bindebende/HILTester/(list of files, cad)

Other CAD files:
ExtensionBoards/PinBed_FOR_A3.stp
ExtensionBoards/PinBed_FOR_A3.skp
