bindebende/HILTester/(threads)

Thread 2 (2017-06-03):

Supply ON/OFF switch

bindebende, 2017-06-03:
Turn on off supply with p-channel mosFET

bindebende, 2017-06-04:
implemented with changing the LDO to TL1963AKTTR.which have internal shdn pin which is pulled up to tstr_3V3

Closed 2017-06-04.

Thread 11 (2017-06-05):

find a suitable power toggle switch

bindebende, 2017-06-05:
switch with 4.7 mm pin spacing
http://hu.farnell.com/multicomp/1ms3t1b5m1qe/switch-spdt-on-off-on-5a-28vdc/dp/9473386

bindebende, 2017-10-11:
Done

Closed 2017-10-11.

Thread 29 (2017-07-23):

Create a break out board for the TIVA c EK with the A2.0 pinout

bindebende, 2017-07-23:
- [ ] Add pull up resistors
- [ ] Add two GEN_IN input for ADC inputs. Connect together with a jumper
- [ ] Add BNC connectors

bindebende, 2017-10-16:
not implemented

Closed 2017-10-16.

Thread 31 (2017-09-22):

add Grouping to pinbed

bindebende, 2017-09-22:
Add pin headers where all the signals are connected from the pins (pogo) and the other side of the pins are connected to the header to the HIL. It could be jumper bypassable. Reason: put a PCB on top of it and change the pogopins which connector they are going for different group of tests.

Thread 34 (2017-10-02):

Add master slave modules

bindebende, 2017-10-02:
Jumper selectable. Modules are connected with communicatin lines RS485,diff I2c

Handshake each module has a ID and when the MCU ask for handshake the slaves will continue it when the delay(ID*millisec) expires. then the master will controll all the message control flow

bindebende, 2017-10-23:
It will be coded in the eeprom

Closed 2017-10-23.

Thread 35 (2017-10-02):

Make the board bottom layer the front panel of case

bindebende, 2017-10-02:
- the multiplexers have to put on the top side
- connectors have to be put on the bottom layer
- put leds which are emmiting on their bottom and add a cut out to the pcb

bindebende, 2017-10-16:
Not implemented

Closed 2017-10-16.

Thread 43 (2017-10-10):

Fix the tarces next to the LDO3's shunt resistor from the MCU

bindebende, 2017-10-10:

bindebende, 2017-10-11:
Done

Closed 2017-10-11.

Thread 45 (2017-10-10):

programer board

bindebende, 2017-10-10:
Turn on and off power rail for all the DUTs programming one at the time (high side on/off p-ch mosfet)

Thread 47 (2017-10-11):

Add board temperature measurement

bindebende, 2017-10-11:
put close to the LDOs
NTC
http://hu.farnell.com/avx/nb20m00333kba/thermistor-ntc-33k-1206/dp/1672317

bindebende, 2017-10-23:
Done

Closed 2017-10-23.

Thread 48 (2017-10-11):

Input divider on analog pins

bindebende, 2017-10-11:
Scope like 1:10 and 1:1 selectable with p-channel MOSFET, or with Relay
some kind of IO expander will be using because there's no 40 free pins available and the switching doesn't have to be fast (max 1Hz per ch)
Dividing options:
* 1:1
* 1:2
* 10:1

IO Expander (40 I/O I2c, Totem pole output, 100kOhm pull up) :
http://hu.farnell.com/nxp/pca9505dgg/ic-i-o-port-i2c-40bit-56tssop/dp/2212087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

Example mosfet (-30Vds )
http://hu.farnell.com/nxp/nx3008pbks/mosfet-pp-ch-30v-200ma-sot363/dp/2069548

bindebende, 2018-02-01:
Or digital too

Thread 54 (2017-10-14):

control output supply voltage of the LDOs

bindebende, 2017-10-14:
* measure input voltage with 1/6 voltage divider
* digital resistor in the feedback signal of the LDO's (remove the fixed resistors)
Cons: +-20% accuracy
http://hu.farnell.com/maxim-integrated-products/ds3501u/digital-pot-10k-single-usop-10/dp/2515880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
* ADC
http://hu.farnell.com/maxim-integrated-products/max11647eua/adc-2-ch-sar-10bit-94-4ksps-umax/dp/2513428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

bindebende, 2017-10-25:
Done

Closed 2017-10-25.

Thread 56 (2017-10-16):

Create order

bindebende, 2017-10-16:
run bom.ulp
Values -> .csv

- [ ] generate BOM
- [ ] search for the components (preferable on farnell)
- [ ] put them in the BOM
- [ ] order components
- [ ] print the layout and try the components if are they fits on
- [ ] order PCB

bindebende, 2017-10-19:
Done

Closed 2017-10-19.

Thread 57 (2017-10-16):

Generate outputs

bindebende, 2017-10-16:
Gerbers:
* Component
    * TOP
    * PADS
    * VIAS
* Solder
    * BOTTOM
    * PADS
    * VIAS
* Component silk
    * Dimension
    * TPLACE
    * TNAMES
* solder silk
    * Dimension
    * BPLACE
    * BNAMES
* solder stop
    * Tstop
* component stop
    * Bstop
* component keepout(cko)
    * TKeepout
* solder keepout(sko)
    * BKeepout
* Drill(ncd, Excellon)
    * Drills
    * Holes

PDF:
* schematic (all the pages)
* layout (without the ground plane)
* assembly drawing

bindebende, 2017-10-16:
Done

Closed 2017-10-16.

Thread 59 (2017-10-16):

Add test pins

bindebende, 2017-10-16:
http://hu.farnell.com/w/c/test-measurement/test-connectors-ic-clips/pcb-test-points/prl/results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

To:
* Multiplexer Control signals
* LDOs Control signal
* GND for scope grounding

bindebende, 2017-10-16:
Done. Add a pin header wher all the pin can be connected

Closed 2017-10-16.

Thread 61 (2017-10-17):

Relay board

bindebende, 2017-10-17:
For signals short to GND, Supply, each other (e.g.: SDA <-> SCL)
Check if a Darlington transistor array needed to drive the relays

Thread 67 (2017-10-18):

Add configuration memmory

bindebende, 2017-10-18:
* PCB specific:
    * HW revision
    * enabled peripherals like (CAN,LIN, SPI)
    * type of the peripherals (Display, SSD1306, 32x64)

* master/slave mode
* Hard error log

bindebende, 2017-10-23:
Done

Closed 2017-10-23.

Thread 72 (2017-10-19):

Add labels to the external (DUT) connector

bindebende, 2017-10-19:
The label place shall be between the connectors and the resistors. The PCB shall be expanded vertically

bindebende, 2017-10-24:
Done

Closed 2017-10-24.

Thread 74 (2017-10-19):

U9 supply is connected to VCC not TSTR_3v3

bindebende, 2017-10-19:
Fixed in schematic

Thread 76 (2017-10-20):

Add reverse protection on programming signals (JTAG, SWD, ICSP)

bindebende, 2017-10-20:
Schottky. Forward voltage might be a concern

Thread 77 (2017-10-20):

Supply's reverse input voltage protection

bindebende, 2017-10-20:
* P-chanel mosFET:
http://hu.farnell.com/on-semiconductor/atp101-tl-h/mosfet-p-ch-30v-25a-atpak/dp/2774815

bindebende, 2017-10-25:
Done

Closed 2017-10-25.

Thread 80 (2017-10-22):

LDO for TSTR_3V3 no input connected to any pin

bindebende, 2017-10-22:
Fixed in the schematic

Thread 81 (2017-10-22):

Isolate DUT inputs

bindebende, 2017-10-22:
For digital signals
http://hu.farnell.com/silicon-labs/si8660ba-b-is1/digital-isolator-8ns-nsoic-16/dp/2423337

bindebende, 2018-02-02:
Not implemented since the current isolation is:
* Current (with resistor)
* Voltage ( with zener diodes)

Closed 2018-02-02.

Thread 85 (2017-10-25):

find a buyable oscillator for the mcu

bindebende, 2017-10-25:
It shall match in the package too

http://hu.farnell.com/qantek-technology-corporation/qc3ca25-0000f18b23m/crystal-25mhz-18pf-3-2mm-x-2-5mm/dp/2508942

bindebende, 2017-10-25:
Done

Closed 2017-10-25.

Thread 102 (2018-02-02):

Flash silta to the discovery board

bindebende, 2018-02-02:
* DFU:

* OpenOCD:
    *  (desolder SB10 jumper)
    * Connect to the stm32f4-discovery board using the mini USB cable AND micro USB cable
    * Connect using openOCD and the included configuration file. $ openocd -f stm32f4xx-openOCD.cfg
    * On a separate terminal window, run arm-none-eabi-gdb $ arm-none-eabi-gdb
    * Connect to openOCD (gdb) target extended-remote localhost:3333
    * Load program the stm32f4xx (gdb) file build/silta.elf (gdb) load
    * To run you program: (gdb) continue

Closed 2018-02-03.
