bindebende/HILTester/HIL/Output/PDF/HIL_SCH.pdf

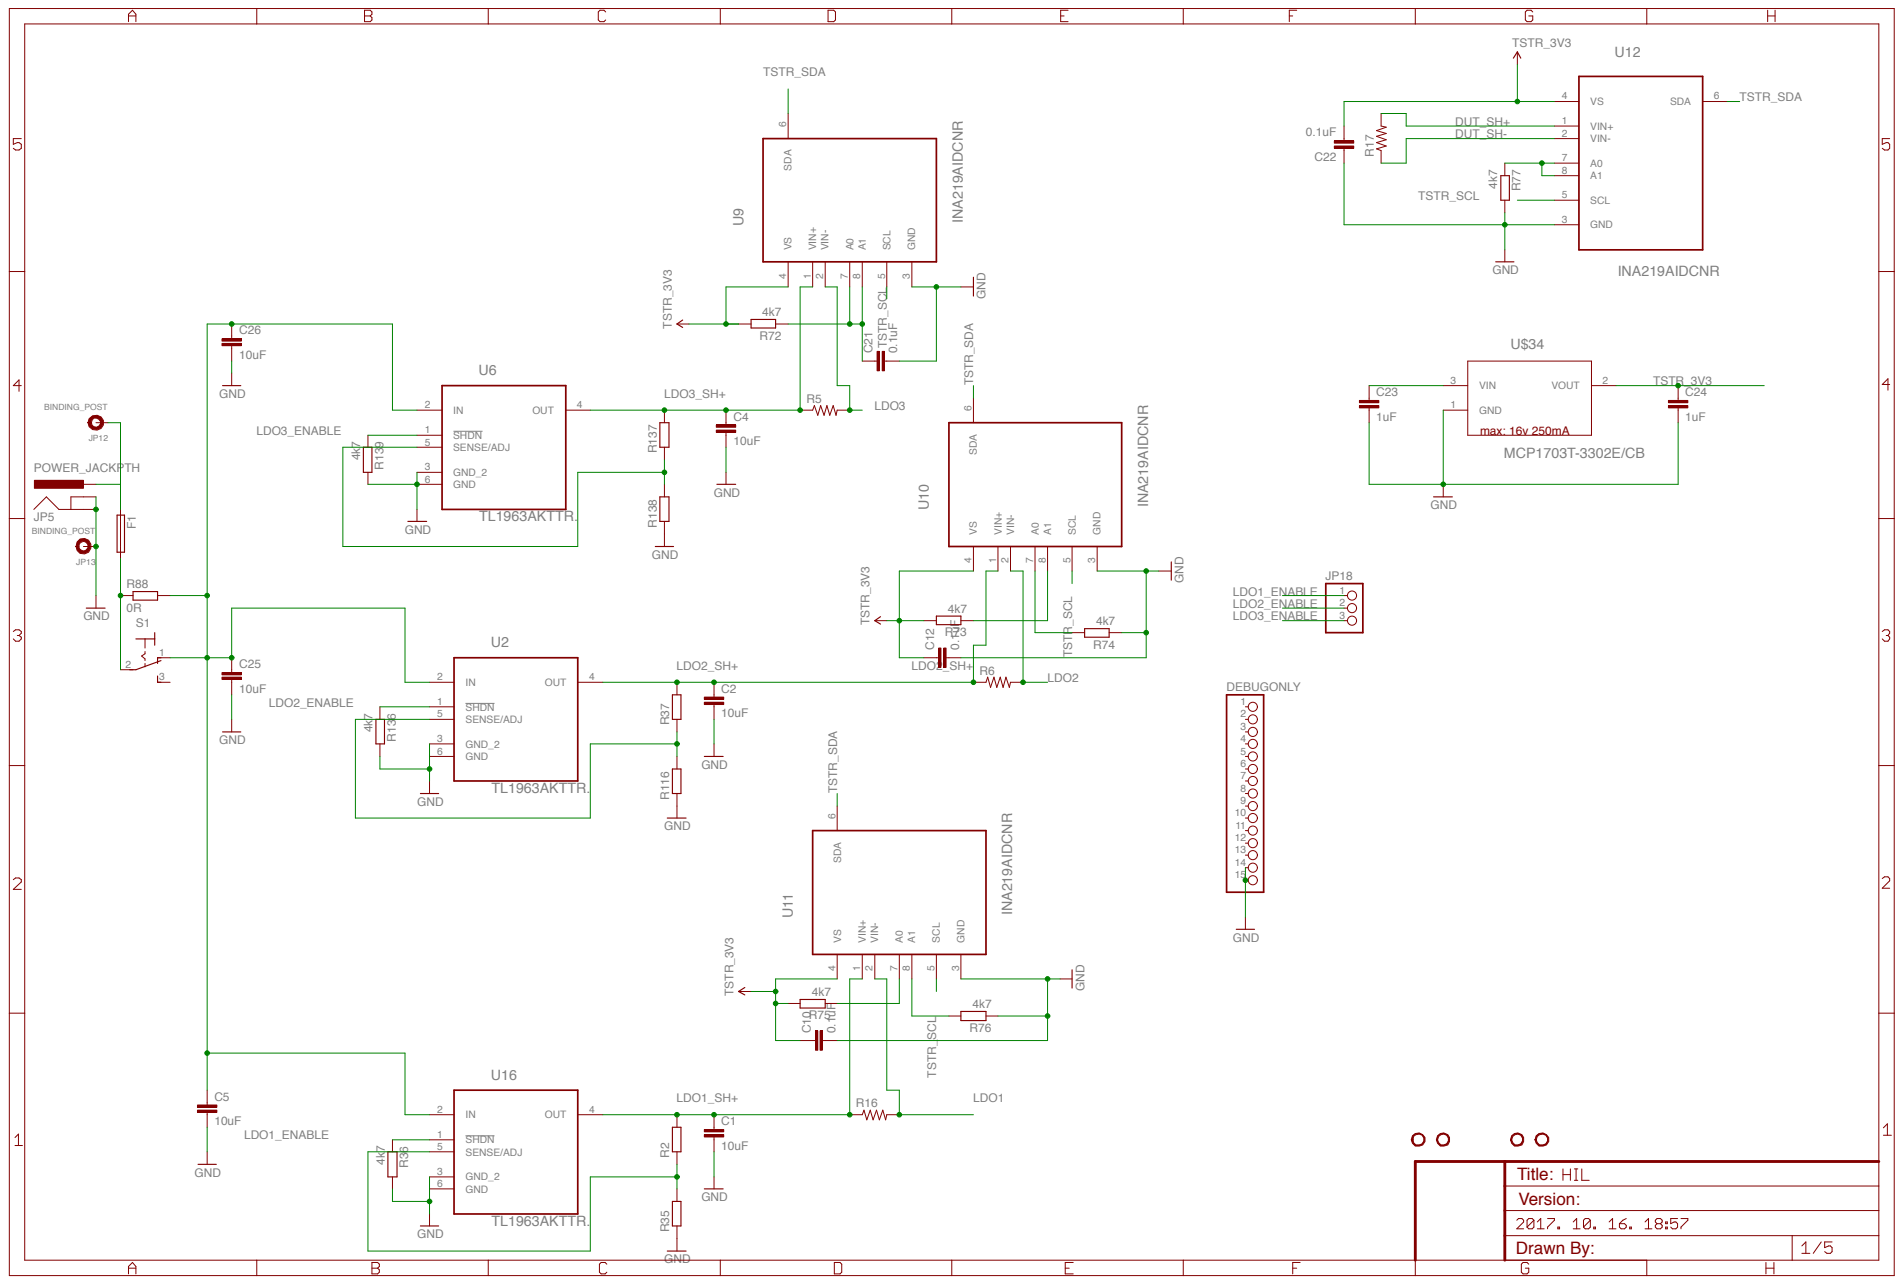
[picture p1: page 1]

TSTR_3V3

VIN+ 1

GND_2 3

Title:

# TSTR_3V3 DUT_CS_RecieveAllMSG4.7k GND

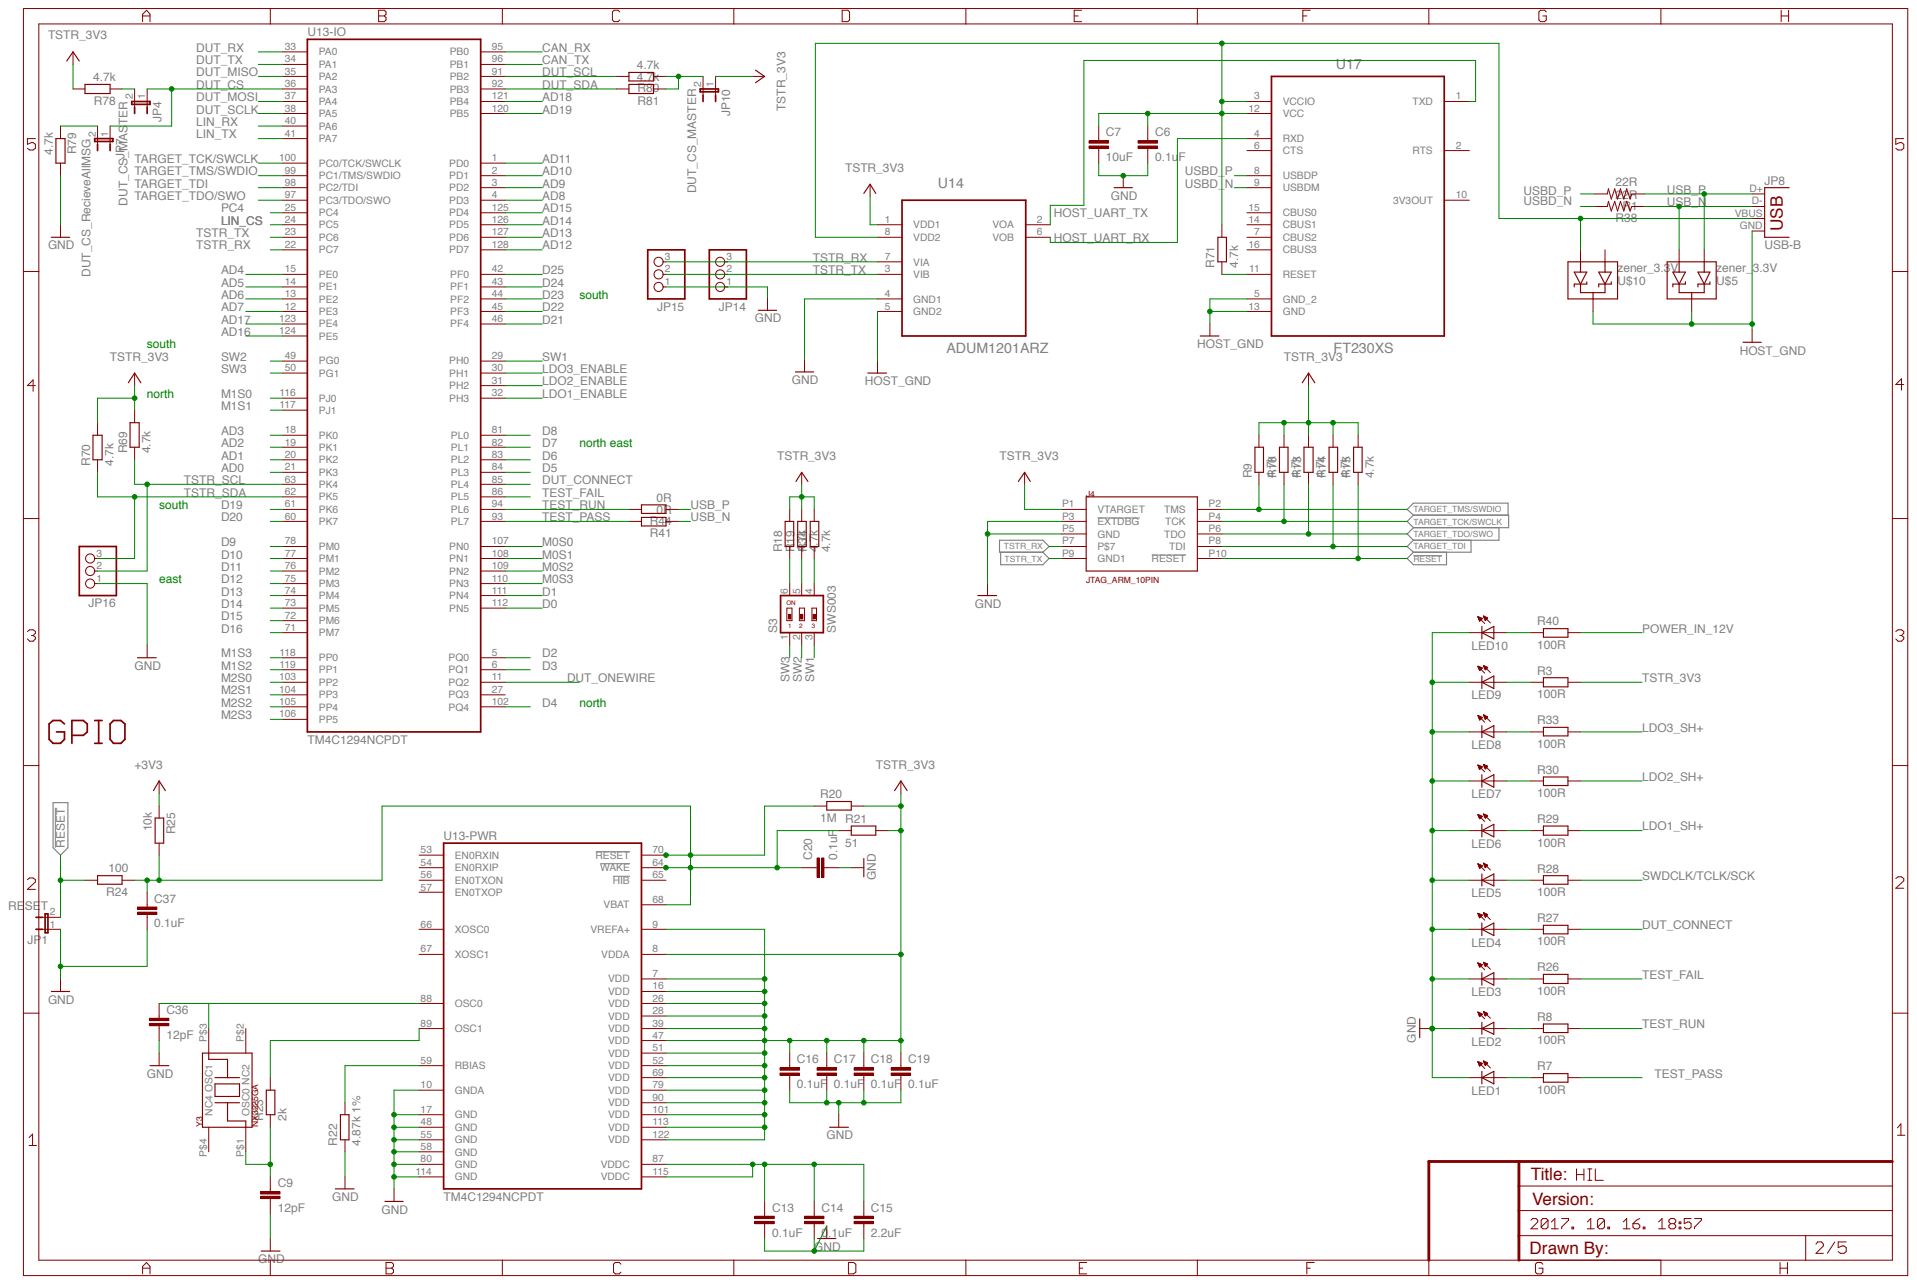
[picture p2: page 2]

# GND ⁴k7

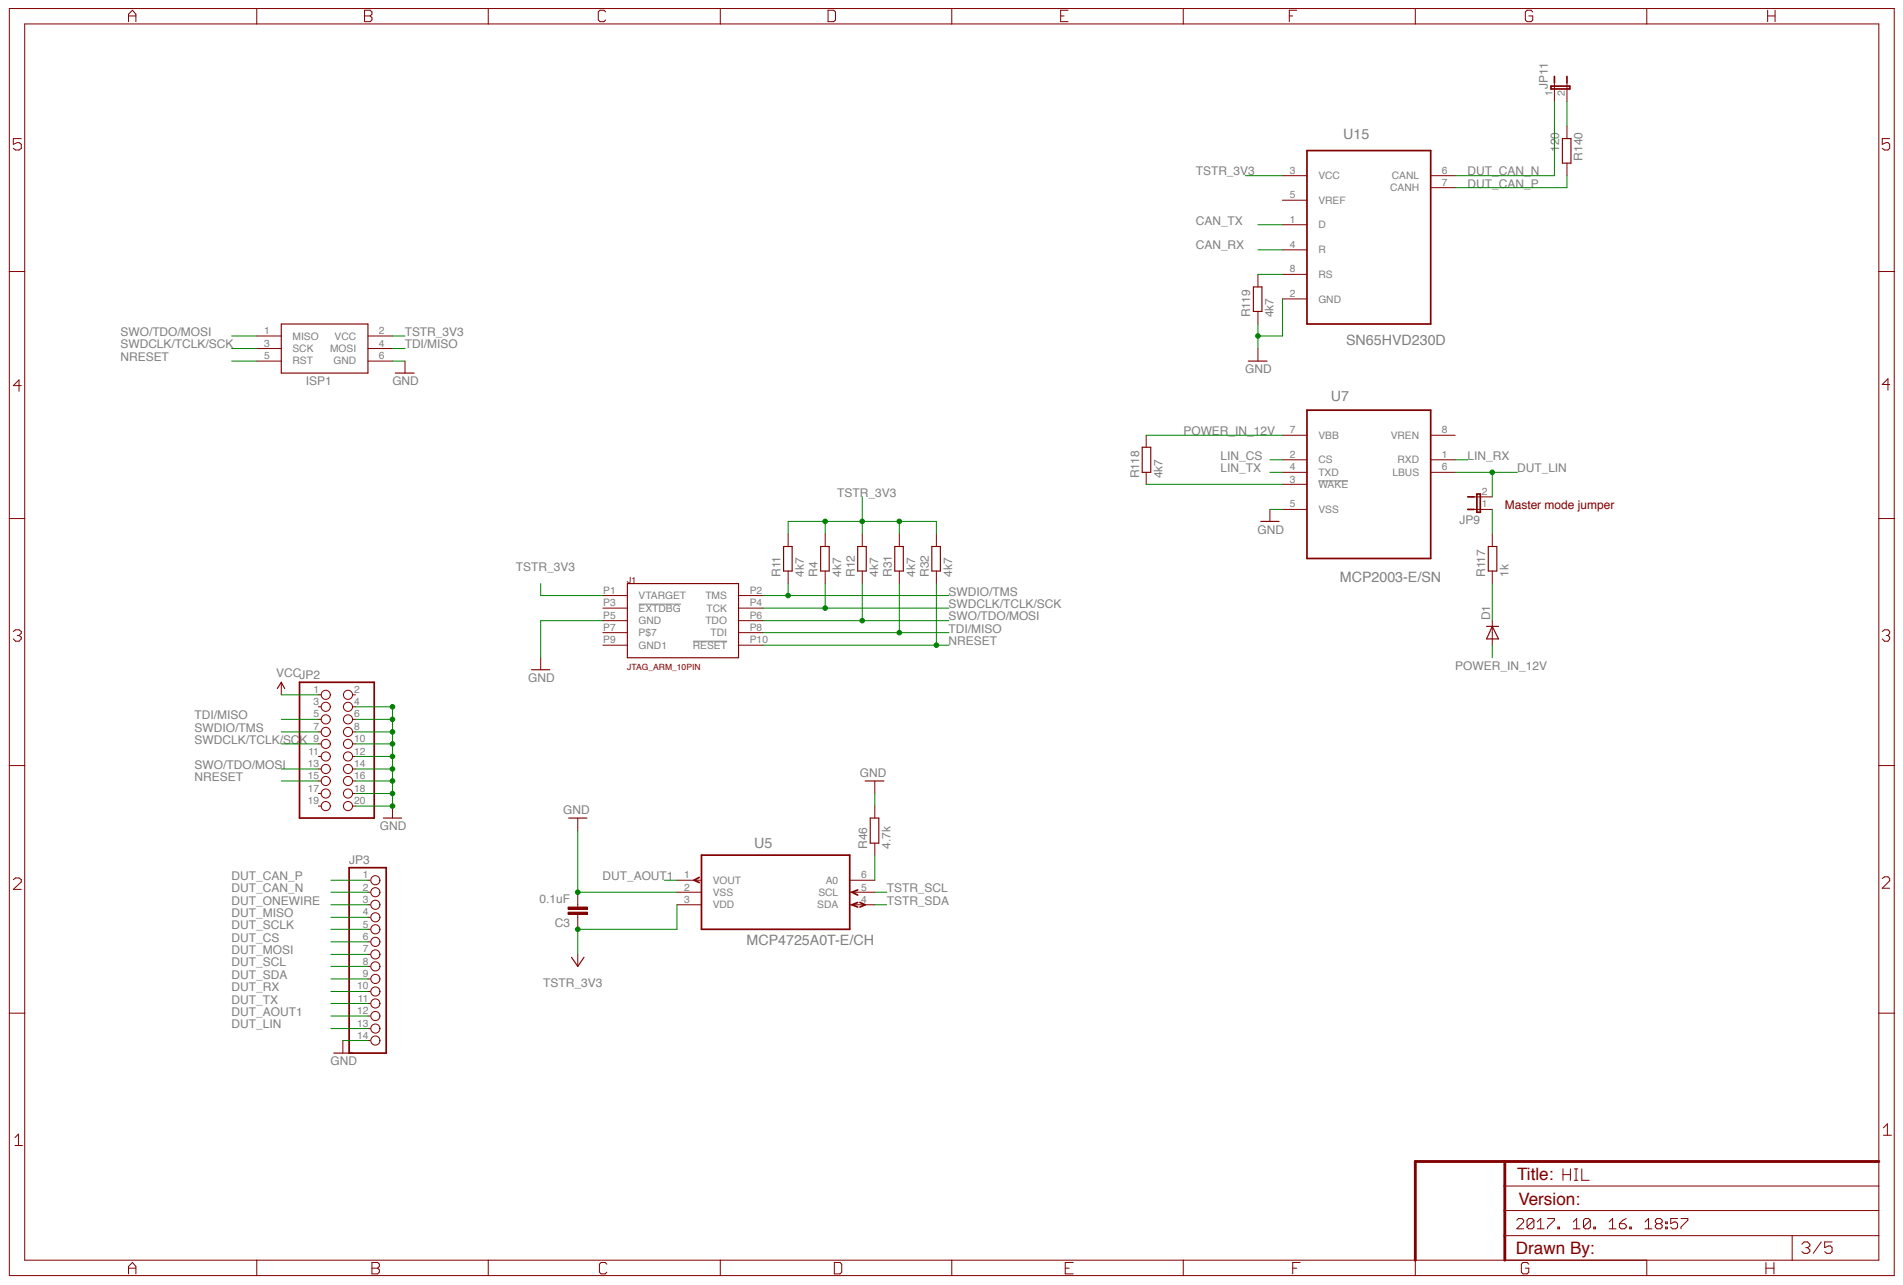
[picture p3: page 3]

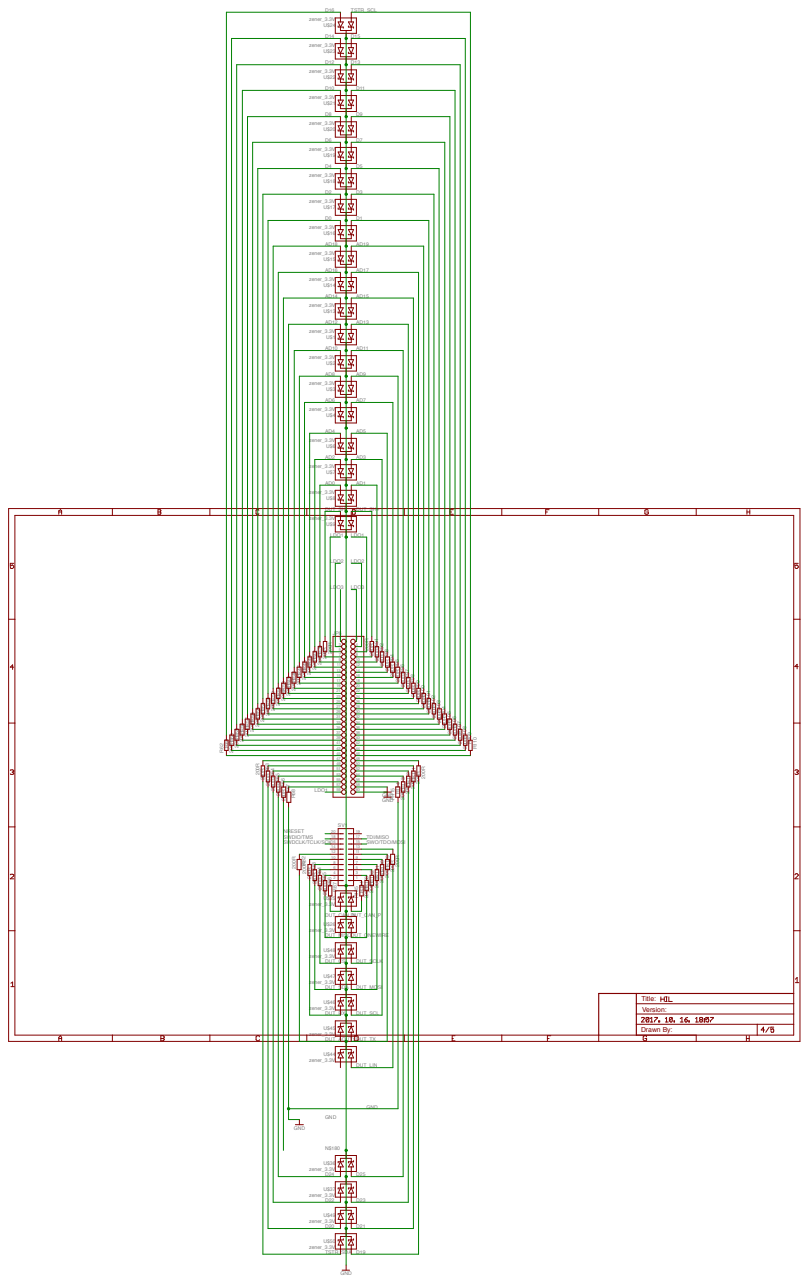
[picture p4: page 4]

zener_3.3V U$23

zener_3.3V U$22

zener_3.3V U$21

zener_3.3V U$20

zener_3.3V U$19

zener_3.3V U$18

zener_3.3V U$17

zener_3.3V U$16

zener_3.3V U$15

zener_3.3V U$14

zener_3.3V U$13

zener_3.3V U$2

zener_3.3V U$3

zener_3.3V U$6

zener_3.3V U$7

DUT_CAN_NDUT_CAN_P U$26 DUT_MISODUT_ONEWIRE

Drawn By:

DUT_AOUT1 | DUT_TX DUT_LIN

U$37 zener_3.3V D22 | | D23

U$49 zener_3.3V D20 | | D21

U$50 zener_3.3V

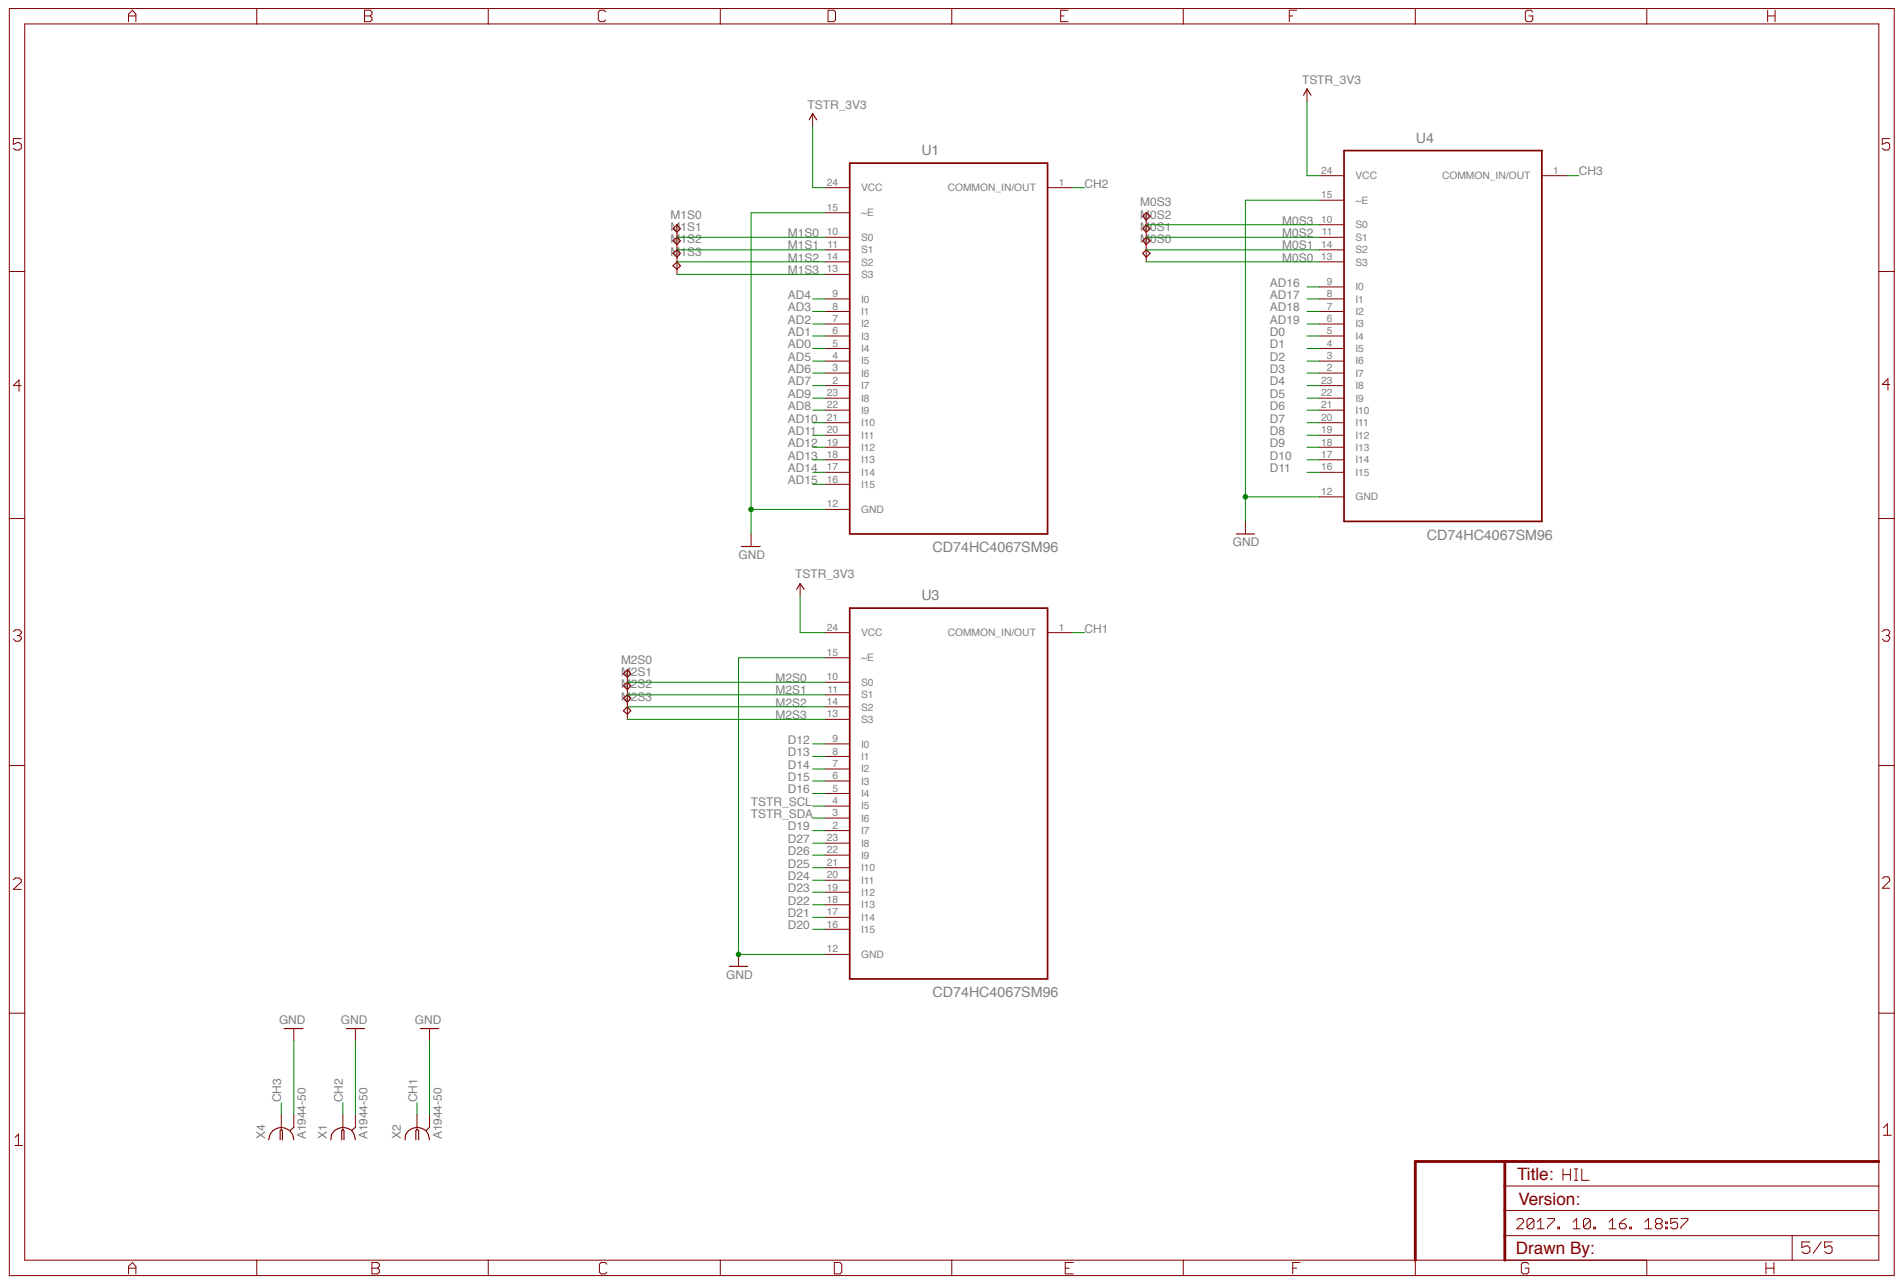
[picture p5: page 5]
