bindebende/HILTester/HIL/Output/PDF/HIL_ASM_TOP.pdf

*

1

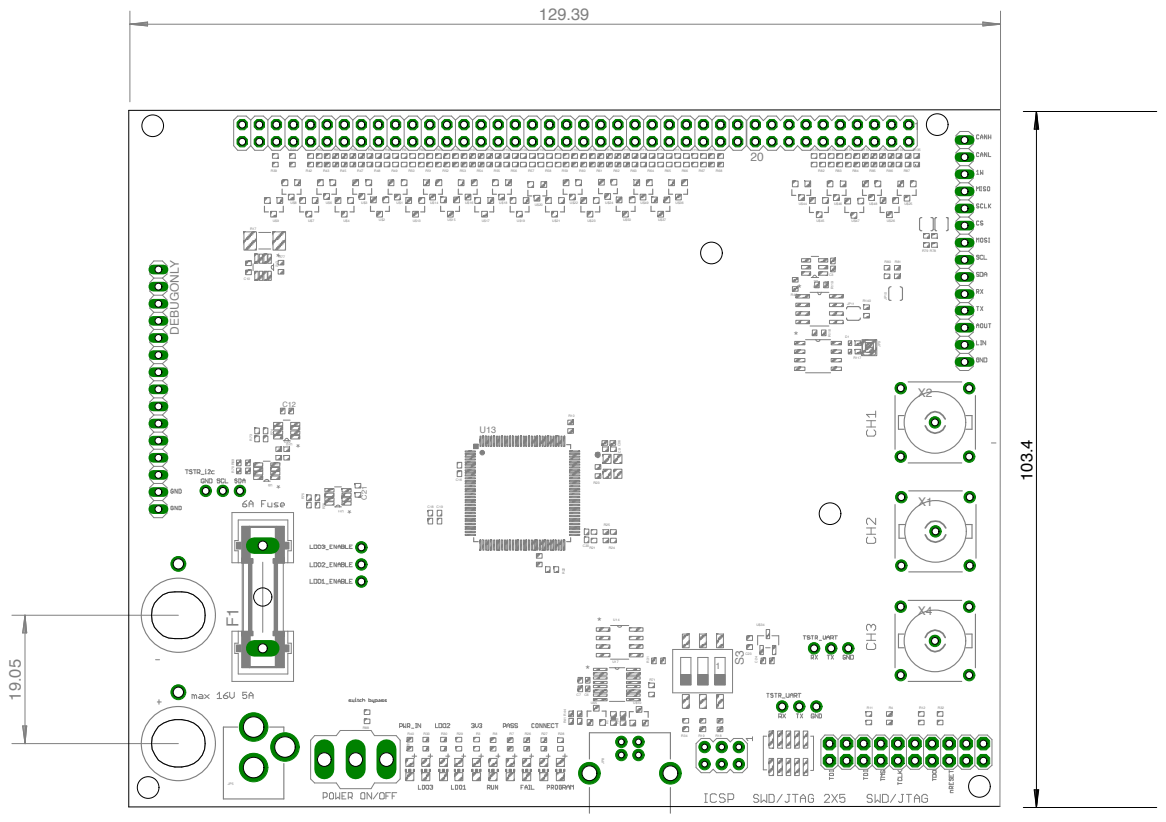
[picture p6: page 1]
