bindebende/HILTester/HIL/Output/PDF/HIL_LAY_BOTTOM.pdf

* | * M2S3 *

129.39

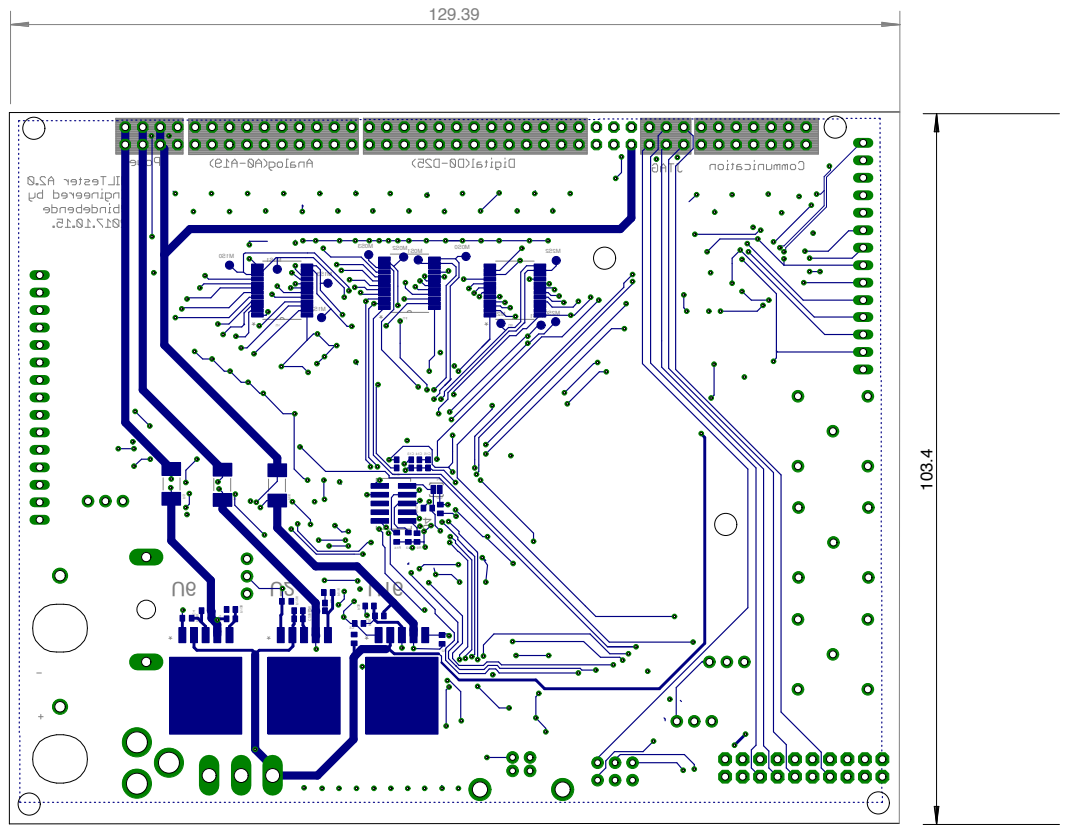
[picture p7: page 1]
