bindebende/HILTester/HIL/Output/PDF/HIL_LAY_TOP.pdf

*

1

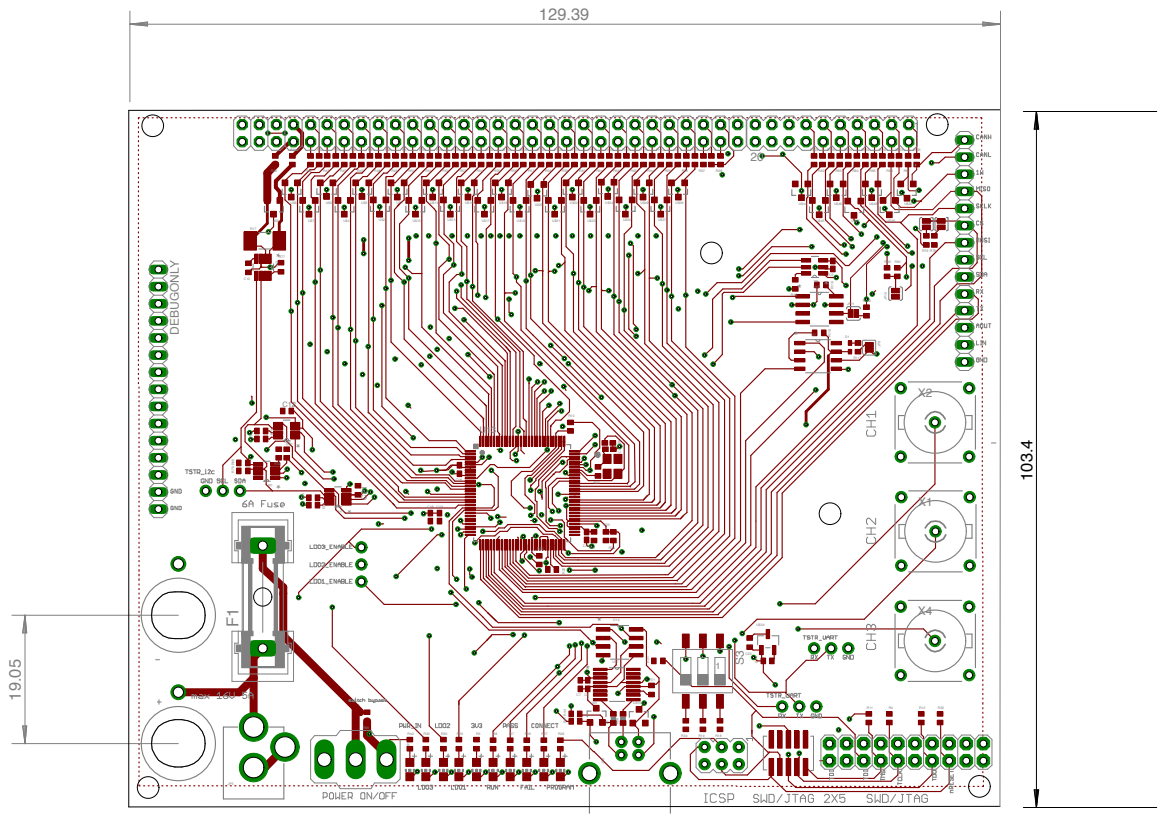
[picture p8: page 1]
