bindebende/HILTester/HIL/HIL.brd

## EAGLE design HIL/HIL.brd (2018-02-04)

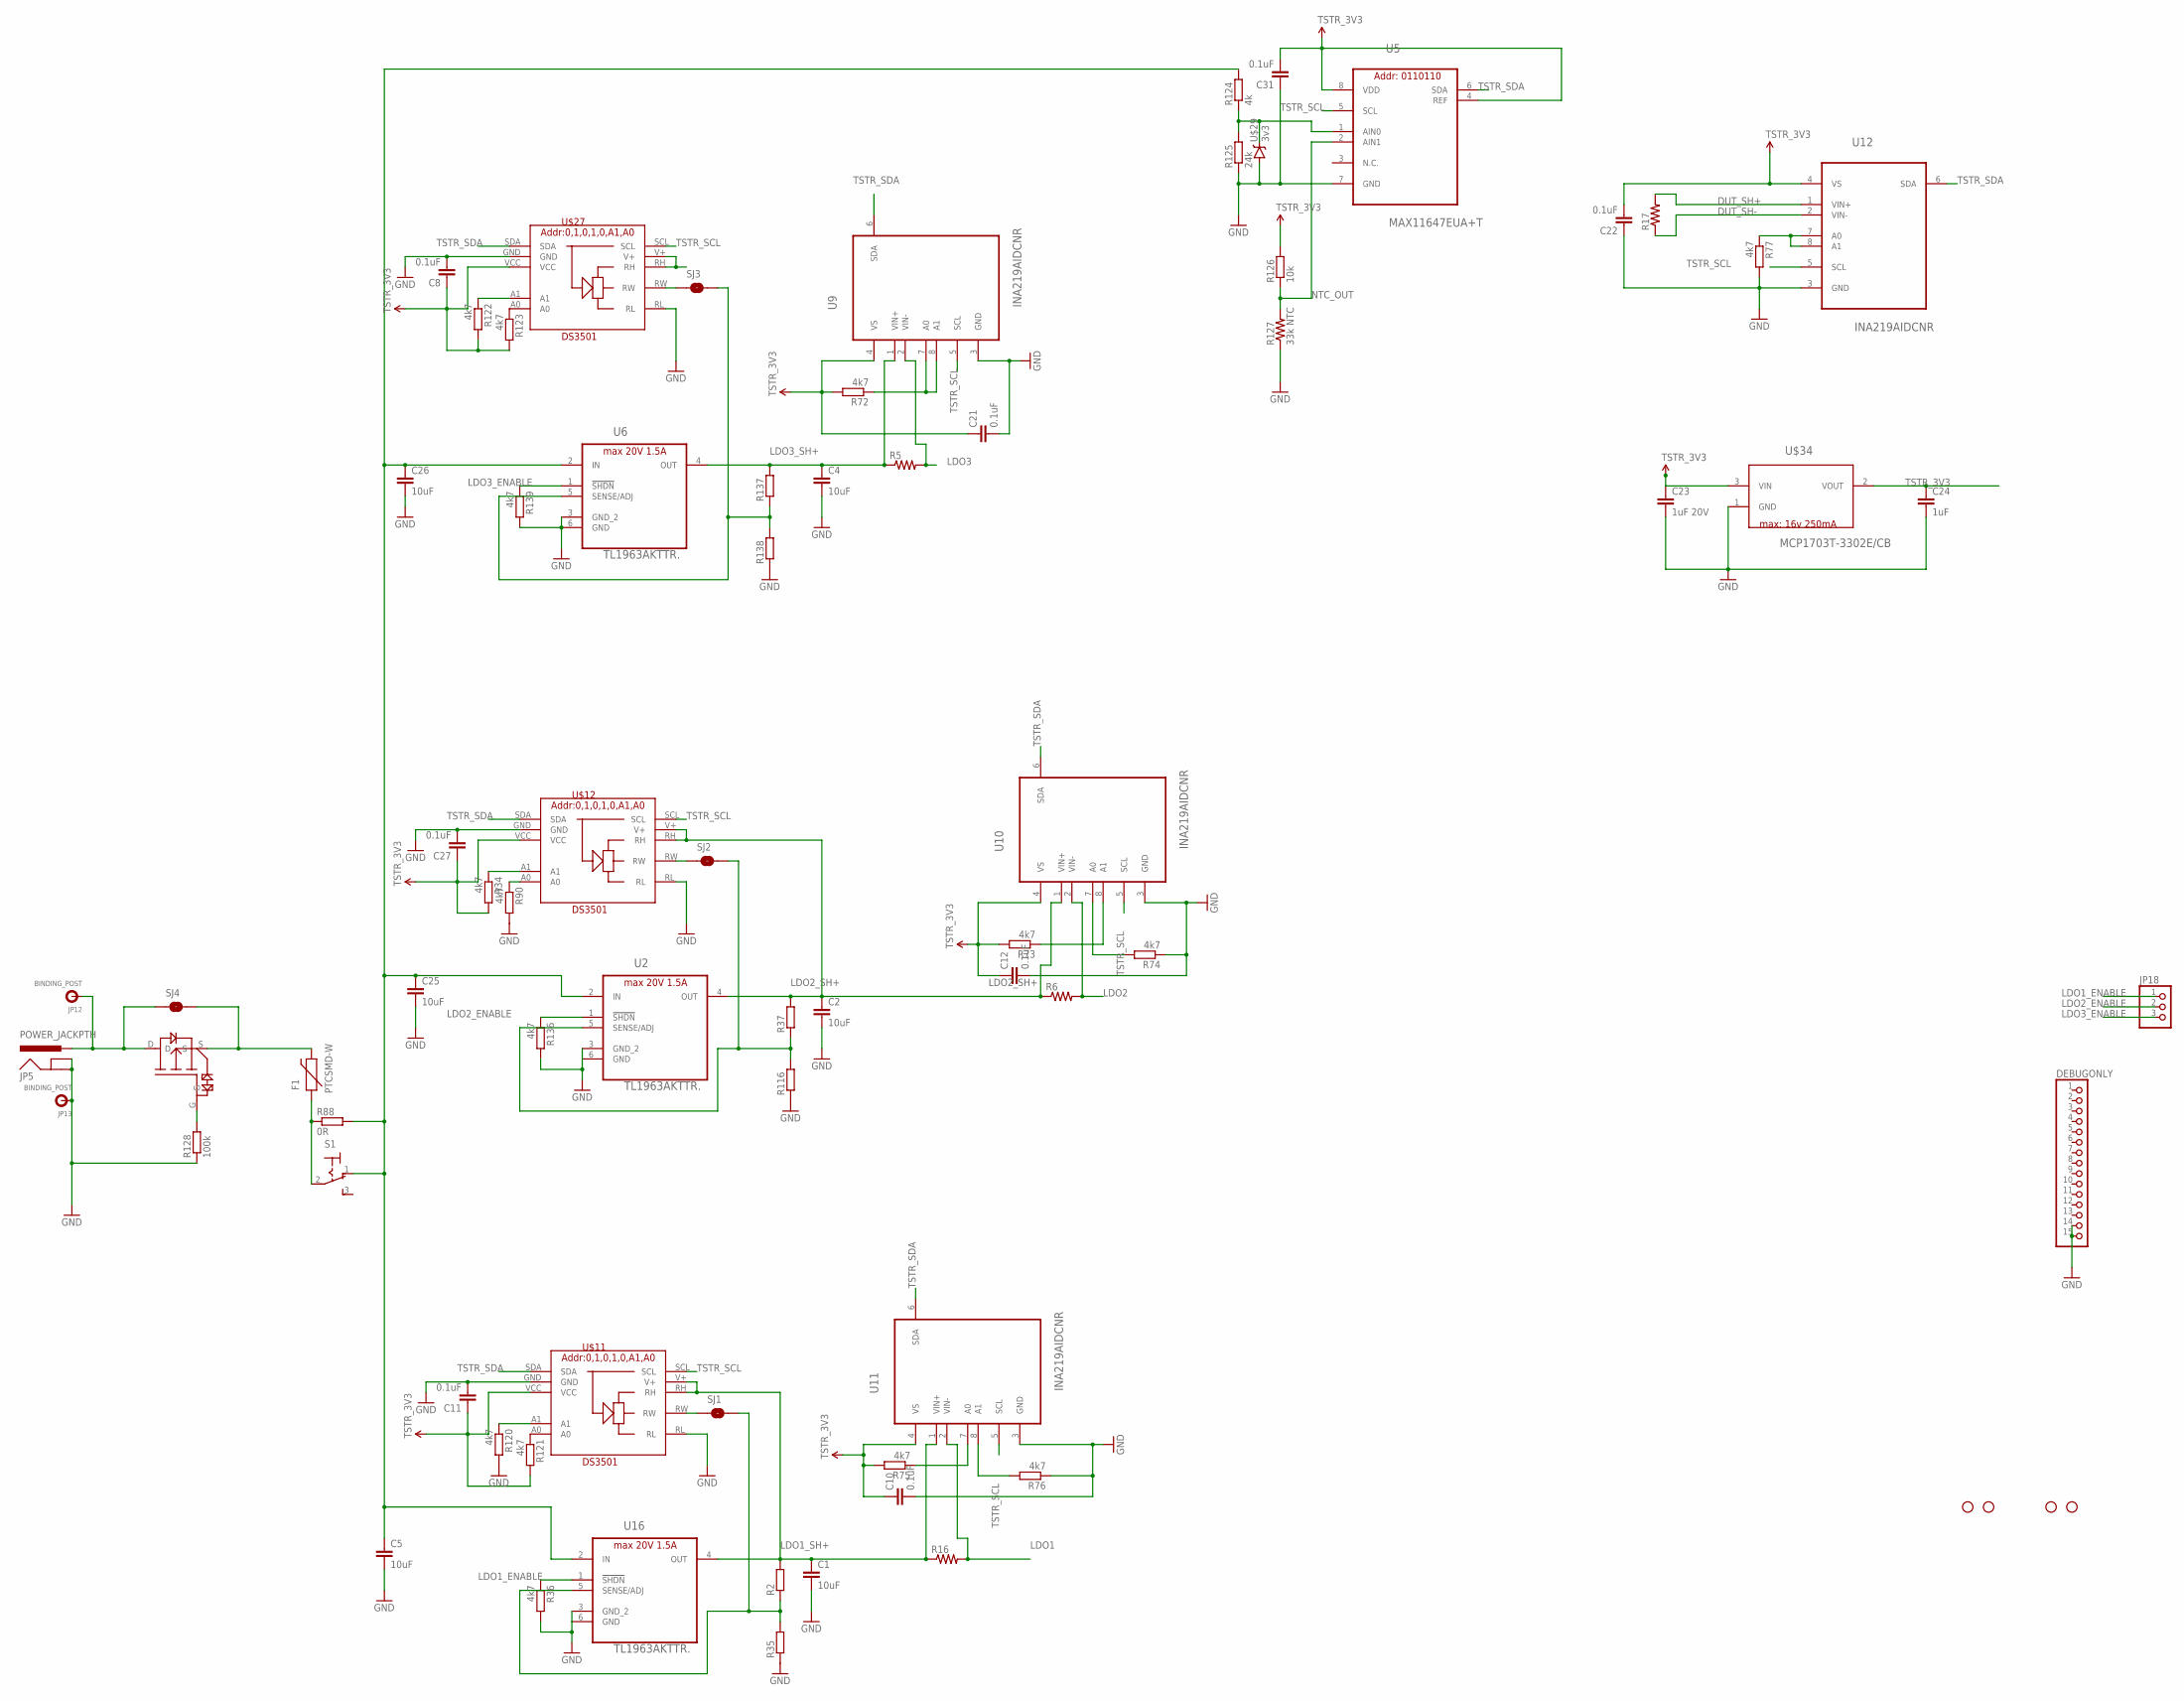
[picture p9: schematic HIL.sch, sheet 1, Power]

Parts:
C1, C2, C4, C5, C25, C26: 10uF; C0402
C8, C10, C11, C12, C21, C22, C27, C31: 0.1uF; C0402
C23: 1uF 20V; C0402
C24: 1uF; C0402
DEBUGONLY: PINHD-1X15; 1X15
F1: PTCSMD-W; PTC-1206-WIDE
JP5: POWER_JACKPTH; POWER_JACK_PTH
JP12, JP13: BINDING_POST
JP18: PINHD-1X3CB; 1X03-CLEANBIG
R2, R35, R37, R116, R137, R138: R-EU_R0402; R0402
R5, R6, R16, R17: R-US_R5025; R5025
R34, R36, R72, R73, R74, R75, R76, R77, R90, R120, R121, R122, R123, R136, R139: 4k7; R0402
R88: 0R; R0402
R124: 4k; R0402
R125: 24k; R0402
R126: 10k; R0402
R127: 33k NTC; 1206
R128: 100k; R0402
S1: 320-916
SJ1, SJ2, SJ3, SJ4: SOLDERJUMPERROUND; SJ_ROUND
STANDOFF2, STANDOFF3, STANDOFF4, STANDOFF6: STAND-OFF
U2, U6, U16: TL1963AKTTR.; TO170P1485X457-6N
U5: MAX11647EUA+T; SOP65P490X110-8N
U9, U10, U11, U12: INA219AIDCNR; SOT65P280X145-8N
U$11, U$12, U$27: DS3501
U$29: 3v3; SOT23-3
U$31: ATP101; ATPACK
U$34: MCP1703T-3302E/CB; SOT95P300X145-3N

Connections:
AS: R72.1, U9.7 (A0), U9.8 (A1)
DUT_SH+: R17.2, U12.1 (VIN+); also elsewhere on the board
DUT_SH-: R17.1, U12.2 (VIN-); also elsewhere on the board
GND: C1.2, C2.2, C4.2, C5.2, C8.2, C10.2, C11.2, C12.2, C21.2, C22.1, C23.2, C24.2, C25.2, C26.2, C27.2, C31.1, DEBUGONLY.14, DEBUGONLY.15, JP5.GND, JP5.GNDBREAK, JP13.P$1, R35.1, R36.2, R74.1, R76.1, R77.2, R90.2, R116.1, R120.2, R125.1, R127.1, R128.1, R136.2, R138.1, R139.2, U2.3 (GND_2), U2.6 (GND), U5.7 (GND), U6.3 (GND_2), U6.6 (GND), U9.3 (GND), U10.3 (GND), U11.3 (GND), U12.3 (GND), U16.3 (GND_2), U16.6 (GND), U$11.GND, U$11.RL, U$12.GND, U$12.RL, U$27.GND, U$27.RL, U$29.2 (A), U$34.1 (GND); also elsewhere on the board
LDO1: R16.2, U11.2 (VIN-); also elsewhere on the board
LDO1_ADJ: R2.1, R35.2, SJ1.2, U16.5 (SENSE/ADJ)
LDO1_ENABLE: JP18.1, R36.1, U16.1 (!SHDN)
LDO1_RW: SJ1.1, U$11.RW
LDO1_SH+: C1.1, R2.2, R16.1, U11.1 (VIN+), U16.4 (OUT), U$11.RH, U$11.V+; also elsewhere on the board
LDO2: R6.2, U10.2 (VIN-); also elsewhere on the board
LDO2_ADJ: R37.1, R116.2, SJ2.2, U2.5 (SENSE/ADJ)
LDO2_ENABLE: JP18.2, R136.1, U2.1 (!SHDN)
LDO2_RW: SJ2.1, U$12.RW
LDO2_SH+: C2.1, R6.1, R37.2, U2.4 (OUT), U10.1 (VIN+), U$12.RH, U$12.V+; also elsewhere on the board
LDO3: R5.2, U9.2 (VIN-); also elsewhere on the board
LDO3_ADJ: R137.1, R138.2, SJ3.2, U6.5 (SENSE/ADJ)
LDO3_ENABLE: JP18.3, R139.1, U6.1 (!SHDN)
LDO3_RW: SJ3.1, U$27.RW
LDO3_SH+: C4.1, R5.1, R137.2, U6.4 (OUT), U9.1 (VIN+); also elsewhere on the board
unnamed: F1.1, R88.1, S1.2
unnamed: R128.2, U$31.G
unnamed: R73.1, U10.8 (A1)
unnamed: R75.1, U11.7 (A0)
unnamed: R74.2, U10.7 (A0)
unnamed: R76.2, U11.8 (A1)
unnamed: R77.1, U12.7 (A0), U12.8 (A1)
unnamed: R120.1, U$11.A1
unnamed: R121.1, U$11.A0
unnamed: R34.1, U$12.A1
unnamed: R90.1, U$12.A0
unnamed: R122.1, U$27.A1
unnamed: R123.1, U$27.A0
unnamed: U$27.RH, U$27.V+
NTC_OUT: R126.1, R127.2, U5.2 (AIN1)
POWER_IN_12V: C5.1, C23.1, C25.1, C26.1, R88.2, R124.2, S1.1 (O), U2.2 (IN), U6.2 (IN), U16.2 (IN), U$34.3 (VIN); also elsewhere on the board
SUPPLY_DIV: R124.1, R125.2, U5.1 (AIN0), U$29.1 (C)
TSTR_3V3: C8.1, C10.1, C11.1, C12.1, C21.1, C22.2, C24.1, C27.1, C31.2, R34.2, R72.2, R73.2, R75.2, R121.2, R122.2, R123.2, R126.2, U5.4 (REF), U5.8 (VDD), U9.4 (VS), U10.4 (VS), U11.4 (VS), U12.4 (VS), U$11.VCC, U$12.VCC, U$27.VCC, U$34.2 (VOUT); also elsewhere on the board
TSTR_SCL: U5.5 (SCL), U9.5 (SCL), U10.5 (SCL), U11.5 (SCL), U12.5 (SCL), U$11.SCL, U$12.SCL, U$27.SCL; also elsewhere on the board
TSTR_SDA: U5.6 (SDA), U9.6 (SDA), U10.6 (SDA), U11.6 (SDA), U12.6 (SDA), U$11.SDA, U$12.SDA, U$27.SDA; also elsewhere on the board
VIN: F1.2, SJ4.2, U$31.S
VIN_REV: JP5.PWR, JP12.P$1, SJ4.1, U$31.D

Notes on the sheet:
max: 16v 250mA

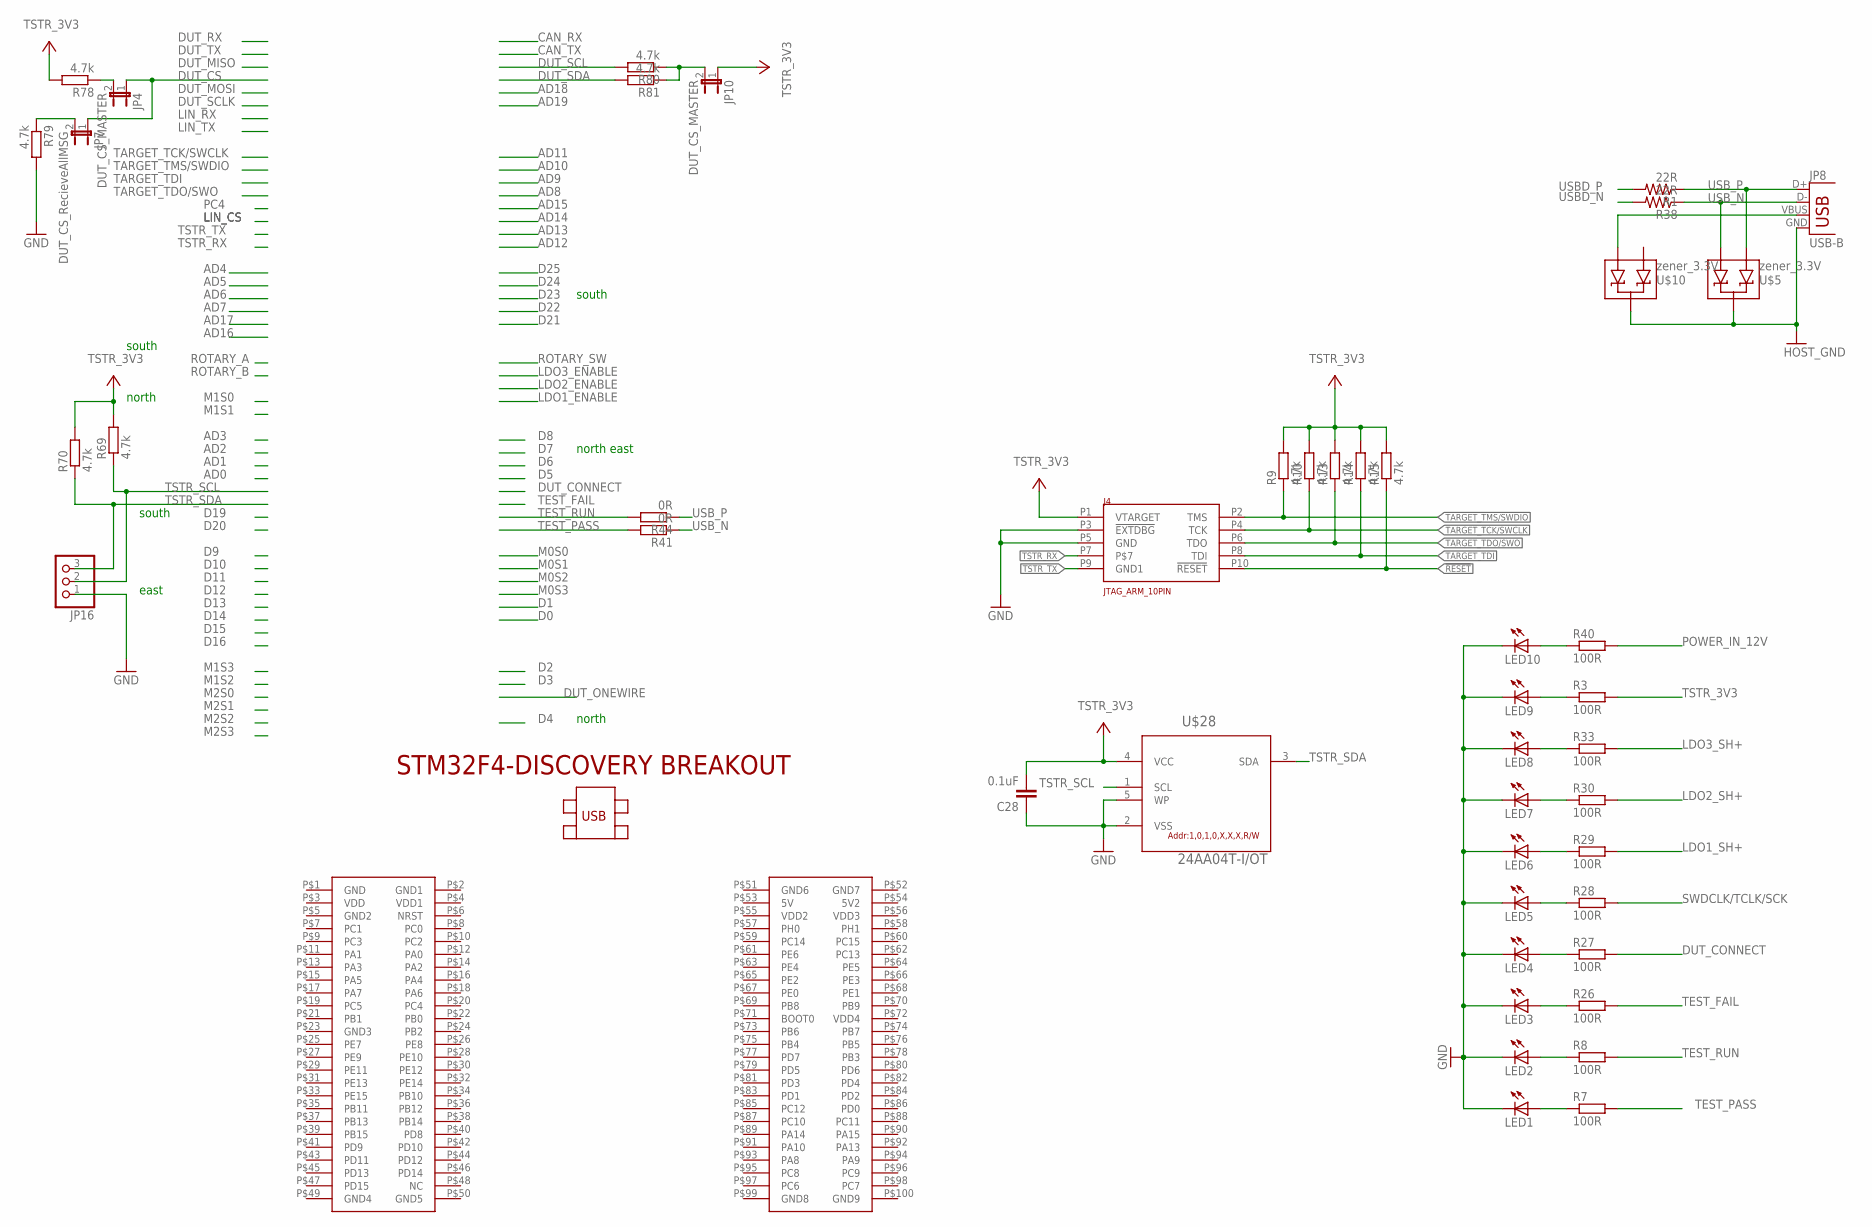
[picture p10: schematic HIL.sch, sheet 2, MCU]

Parts:
C28: 0.1uF; C0402K
J4: JTAG_ARM_10PIN; CON_2X5_50MIL
JP4, JP10: DUT_CS_MASTER; SJ_2S-NO
JP7: DUT_CS_RecieveAllMSG; SJ_2S-NO
JP8: USB-B; USB-B-PTH
JP16: PINHD-1X3CB; 1X03-CLEANBIG
LED1, LED2, LED3, LED4, LED5, LED6, LED7, LED8, LED9, LED10: LEDCHIP-LED0805; CHIP-LED0805
R1, R38: 22R; 0402-RES
R3, R7, R8, R26, R27, R28, R29, R30, R33, R40: 100R; R0402
R9, R10, R13, R14, R15, R69, R70, R78, R79, R80, R81: 4.7k; R0402
R41, R44: 0R; R0402
U$5, U$10: zener_3.3V; SOT23-3
U$28: 24AA04T-I/OT; SOT95P290X145-5N
U$30: STM32F4-DISCOVERY_STM32F4-DISCOVERY

Connections:
!RESET: J4.P10 (!RESET), R15.1
DUT_CONNECT: R27.2
DUT_CS: JP4.1, JP7.1; also elsewhere on the board
DUT_SCL: R80.2; also elsewhere on the board
DUT_SDA: R81.2; also elsewhere on the board
GND: C28.1, J4.P3 (!EXTDBG), J4.P5 (GND), JP16.1, LED1.C, LED2.C, LED3.C, LED4.C, LED5.C, LED6.C, LED7.C, LED8.C, LED9.C, LED10.C, R79.2, U$28.2 (VSS), U$28.5 (WP); also elsewhere on the board
HOST_GND: JP8.GND, U$5.3 (C), U$10.3 (C)
LDO1_SH+: R29.2; also elsewhere on the board
LDO2_SH+: R30.2; also elsewhere on the board
LDO3_SH+: R33.2; also elsewhere on the board
unnamed: LED2.A, R8.1
unnamed: LED1.A, R7.1
unnamed: LED3.A, R26.1
unnamed: LED4.A, R27.1
unnamed: LED5.A, R28.1
unnamed: LED6.A, R29.1
unnamed: LED7.A, R30.1
unnamed: LED8.A, R33.1
unnamed: JP7.2, R79.1
unnamed: JP10.2, R80.1, R81.1
unnamed: JP8.VBUS, U$10.1 (A1)
unnamed: LED9.A, R3.1
unnamed: LED10.A, R40.1
POWER_IN_12V: R40.2; also elsewhere on the board
SWDCLK/TCLK/SCK: R28.2; also elsewhere on the board
TARGET_TCK/SWCLK: J4.P4 (TCK), R10.1
TARGET_TDI: J4.P8 (TDI), R14.1
TARGET_TDO/SWO: J4.P6 (TDO), R13.1
TARGET_TMS/SWDIO: J4.P2 (TMS), R9.1
TEST_FAIL: R26.2
TEST_PASS: R7.2, R41.2
TEST_RUN: R8.2, R44.2
TSTR_3V3: C28.2, J4.P1 (VTARGET), JP10.1, R3.2, R9.2, R10.2, R13.2, R14.2, R15.2, R69.2, R70.2, R78.2, U$28.4 (VCC); also elsewhere on the board
TSTR_RX: J4.P7
TSTR_SCL: JP16.2, R69.1, U$28.1 (SCL); also elsewhere on the board
TSTR_SCL1: JP4.2, R78.1
TSTR_SDA: JP16.3, R70.1, U$28.3 (SDA); also elsewhere on the board
TSTR_TX: J4.P9 (GND1)
USBD_N: R38.2
USBD_P: R1.2
USB_N: JP8.D-, R38.1, R41.1, U$5.1 (A1)
USB_P: JP8.D+, R1.1, R44.1, U$5.2 (A2)

Notes on the sheet:
south
north east
north
east

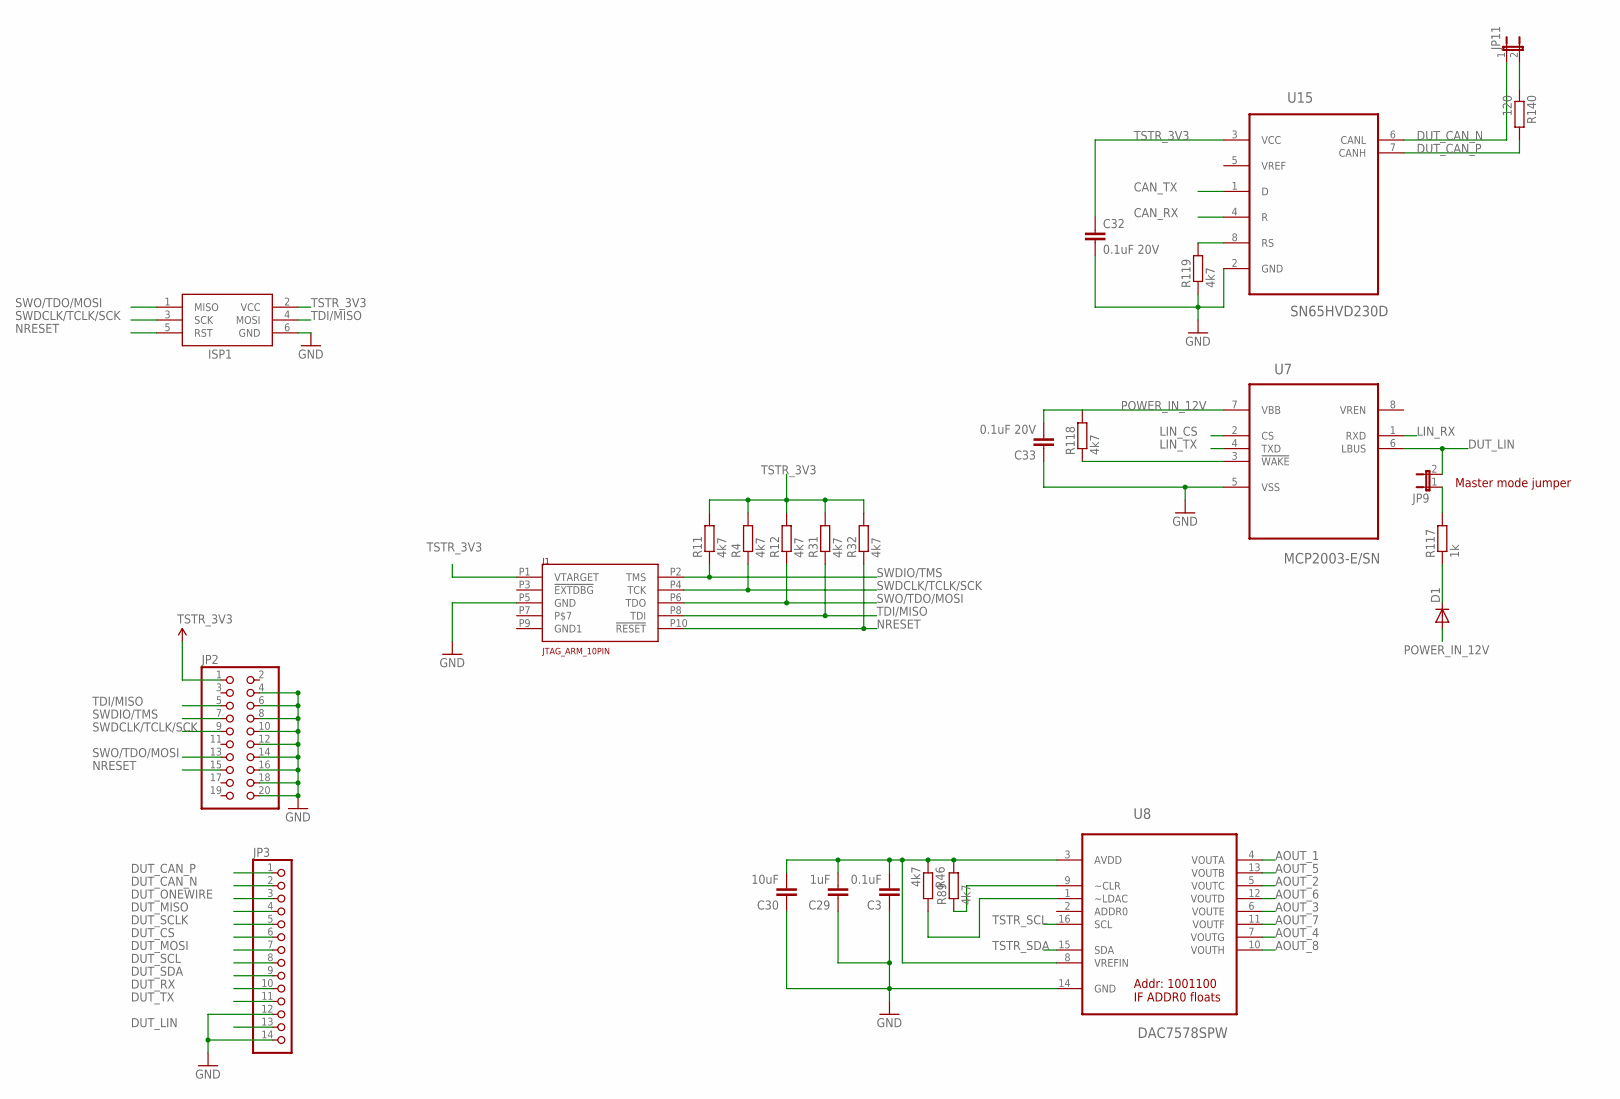
[picture p11: schematic HIL.sch, sheet 3, DUT interface]

Parts:
C3: 0.1uF; C0402K
C29: 1uF; C0402K
C30: 10uF; C0402K
C32, C33: 0.1uF 20V; C0402K
D1: DIODE-SOD523; SOD523
ISP1: AVRISP-6; AVRISP
J1: JTAG_ARM_10PIN; CON_2X5_50MIL
JP2: PINHD-2X10; 2X10
JP3: PINHD-1X14; 1X14
JP9: JUMPER-2SMD-NC; SJ_2S
JP11: JUMPER-2SMD-NO; SJ_2S-NO
R4, R11, R12, R31, R32, R46, R89, R118, R119: 4k7; R0402
R117: 1k; R0402
R140: 120; R0402
U7: MCP2003-E/SN; SOIC127P600X175-8N
U8: DAC7578SPW; SOP65P640X120-16N
U15: SN65HVD230D; SOIC127P600X175-8N

Connections:
AOUT_1: U8.4 (VOUTA); also elsewhere on the board
AOUT_2: U8.5 (VOUTC); also elsewhere on the board
AOUT_3: U8.6 (VOUTE); also elsewhere on the board
AOUT_4: U8.7 (VOUTG); also elsewhere on the board
AOUT_5: U8.13 (VOUTB); also elsewhere on the board
AOUT_6: U8.12 (VOUTD); also elsewhere on the board
AOUT_7: U8.11 (VOUTF); also elsewhere on the board
AOUT_8: U8.10 (VOUTH); also elsewhere on the board
CAN_RX: U15.4 (R)
CAN_TX: U15.1 (D)
DUT_CAN_N: JP3.2, JP11.1, U15.6 (CANL); also elsewhere on the board
DUT_CAN_P: JP3.1, R140.2, U15.7 (CANH); also elsewhere on the board
DUT_CS: JP3.6; also elsewhere on the board
DUT_LIN: JP3.13, JP9.2, U7.6 (LBUS); also elsewhere on the board
DUT_MISO: JP3.4; also elsewhere on the board
DUT_MOSI: JP3.7; also elsewhere on the board
DUT_ONEWIRE: JP3.3; also elsewhere on the board
DUT_RX: JP3.10; also elsewhere on the board
DUT_SCL: JP3.8; also elsewhere on the board
DUT_SCLK: JP3.5; also elsewhere on the board
DUT_SDA: JP3.9; also elsewhere on the board
DUT_TX: JP3.11; also elsewhere on the board
GND: C3.1, C29.1, C30.1, C32.2, C33.1, ISP1.6 (GND), J1.P5 (GND), JP2.4, JP2.6, JP2.8, JP2.10, JP2.12, JP2.14, JP2.16, JP2.18, JP2.20, JP3.12, JP3.14, R119.1, U7.5 (VSS), U8.14 (GND), U15.2 (GND); also elsewhere on the board
LIN_CS: U7.2 (CS)
LIN_RX: U7.1 (RXD)
LIN_TX: U7.4 (TXD)
unnamed: R46.2, U8.1 (~LDAC)
unnamed: JP11.2, R140.1
unnamed: C3.2, C29.2, C30.2, R46.1, R89.2, U8.3 (AVDD), U8.8 (VREFIN)
unnamed: D1.C, R117.1
unnamed: R118.1, U7.3 (!WAKE)
unnamed: JP9.1, R117.2
unnamed: R89.1, U8.9 (~CLR)
unnamed: R119.2, U15.8 (RS)
NRESET: ISP1.5 (RST), J1.P10 (!RESET), JP2.15, R32.1; also elsewhere on the board
POWER_IN_12V: C33.2, D1.A, R118.2, U7.7 (VBB); also elsewhere on the board
SWDCLK/TCLK/SCK: ISP1.3 (SCK), J1.P4 (TCK), JP2.9, R4.1; also elsewhere on the board
SWDIO/TMS: J1.P2 (TMS), JP2.7, R11.1; also elsewhere on the board
SWO/TDO/MOSI: ISP1.1 (MISO), J1.P6 (TDO), JP2.13, R12.1; also elsewhere on the board
TDI/MISO: ISP1.4 (MOSI), J1.P8 (TDI), JP2.5, R31.1; also elsewhere on the board
TSTR_3V3: C32.1, ISP1.2 (VCC), J1.P1 (VTARGET), JP2.1, R4.2, R11.2, R12.2, R31.2, R32.2, U15.3 (VCC); also elsewhere on the board
TSTR_SCL: U8.16 (SCL); also elsewhere on the board
TSTR_SDA: U8.15 (SDA); also elsewhere on the board
VREN: U7.8 (VREN)

Notes on the sheet:
Master mode jumper

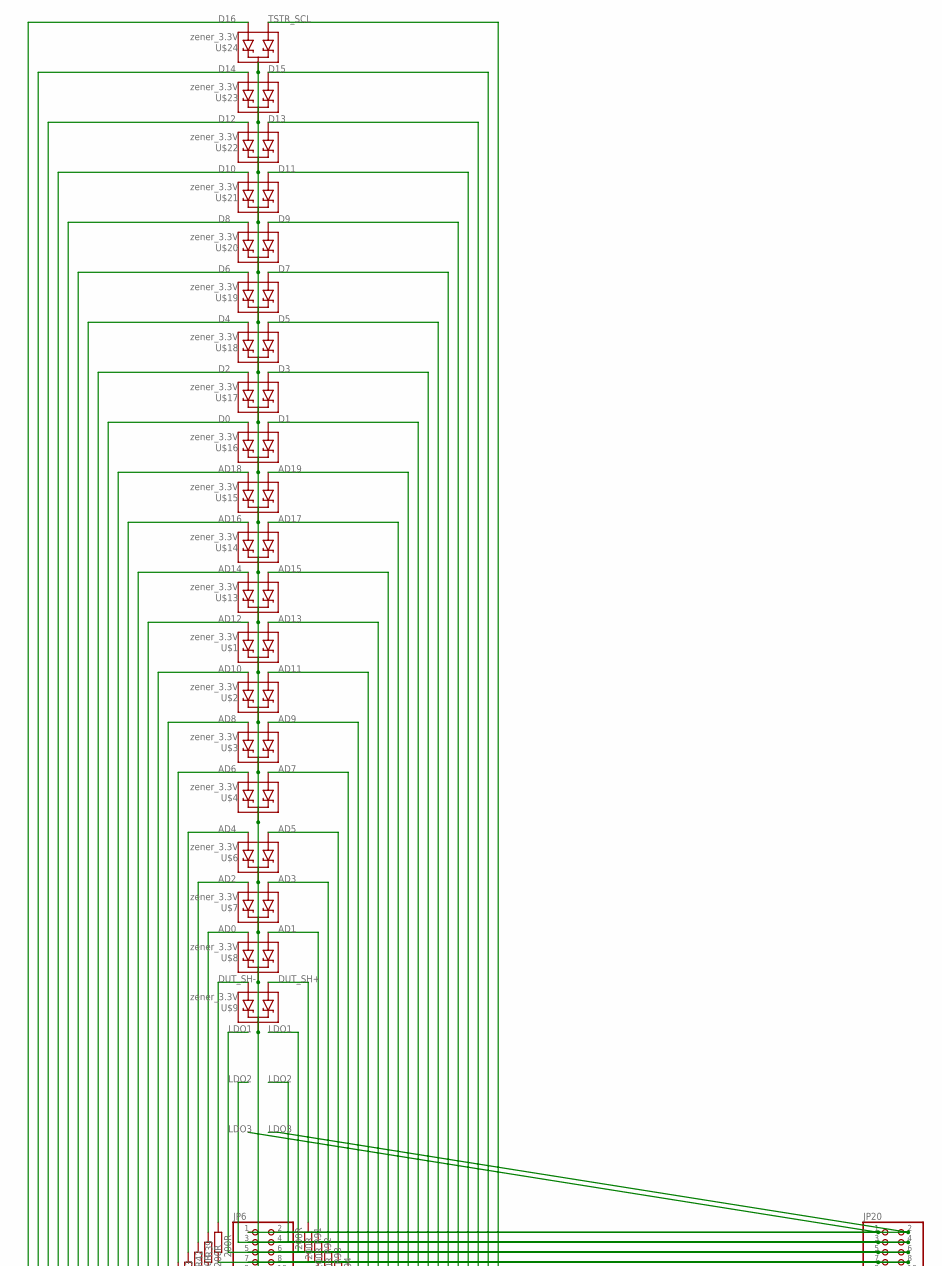
[picture p12: schematic HIL.sch, sheet 4, DUT_Connector, part in row 1, column 1]

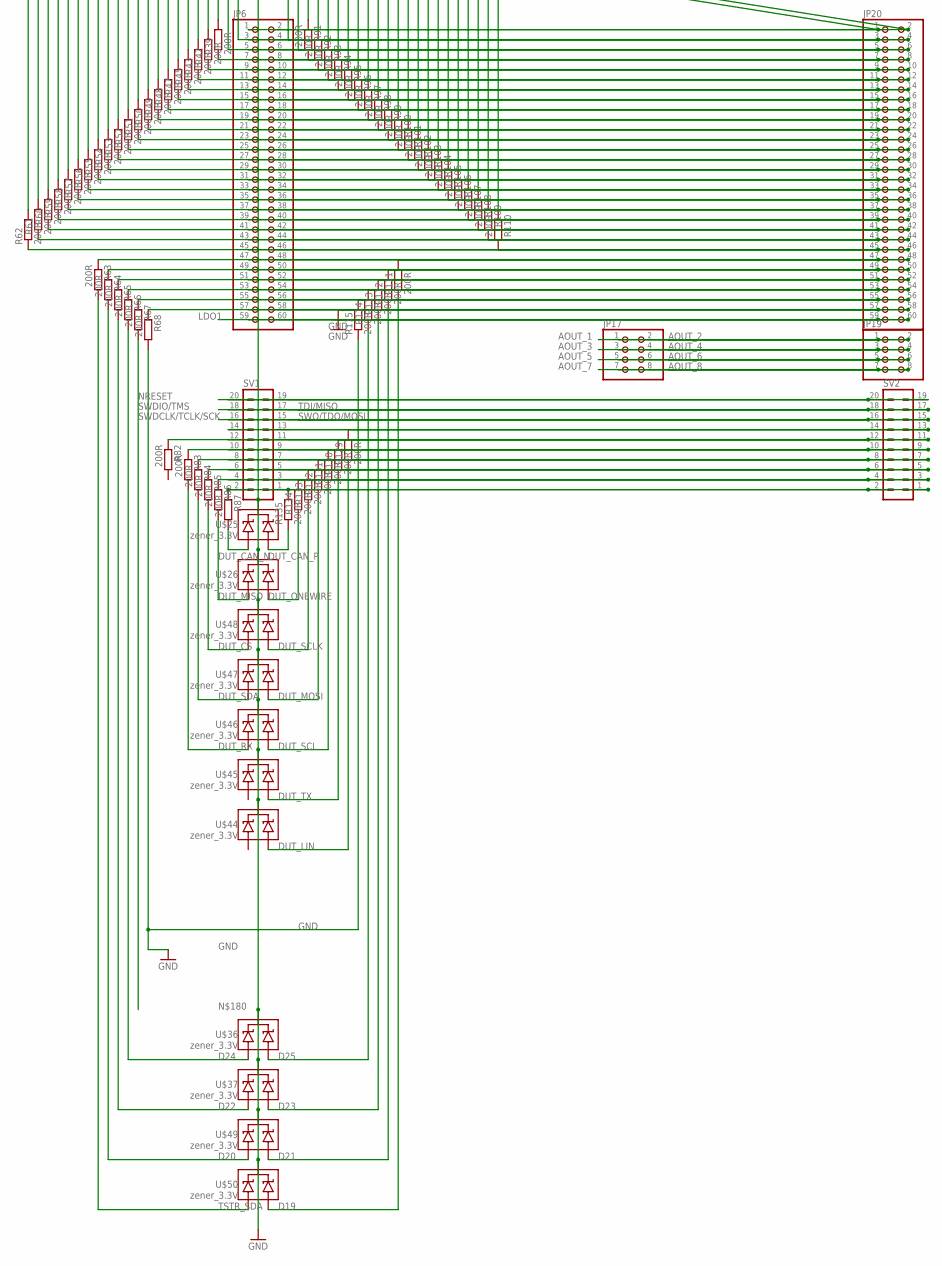
[picture p13: schematic HIL.sch, sheet 4, DUT_Connector, part in row 2, column 1]

Parts:
JP6, JP20: PINHD-2X30; 2X30
JP17, JP19: PINHD-2X4; 2X04
R39, R42, R43, R45, R47, R48, R49, R50, R51, R52, R53, R54, R55, R56, R57, R58, R59, R60, R61, R62, R63, R64, R65, R66, R67, R68, R82, R83, R84, R85, R86, R87, R91, R92, R93, R94, R95, R96, R97, R98, R99, R100, R101, R102, R103, R104, R105, R106, R107, R108, R109, R110, R111, R112, R113, R114, R115, R129, R130, R131, R132, R133, R134, R135: 200R; R0402
SV1, SV2: MA10-2
U$1, U$2, U$3, U$4, U$6, U$7, U$8, U$9, U$13, U$14, U$15, U$16, U$17, U$18, U$19, U$20, U$21, U$22, U$23, U$24, U$25, U$26, U$36, U$37, U$44, U$45, U$46, U$47, U$48, U$49, U$50: zener_3.3V; SOT23-3

Connections:
AD0: R42.2, U$8.2 (A2); also elsewhere on the board
AD1: R92.1, U$8.1 (A1); also elsewhere on the board
AD2: R43.2, U$7.2 (A2); also elsewhere on the board
AD3: R93.1, U$7.1 (A1); also elsewhere on the board
AD4: R45.2, U$6.2 (A2); also elsewhere on the board
AD5: R94.1, U$6.1 (A1); also elsewhere on the board
AD6: R47.2, U$4.2 (A2); also elsewhere on the board
AD7: R95.1, U$4.1 (A1); also elsewhere on the board
AD8: R48.2, U$3.2 (A2); also elsewhere on the board
AD9: R96.1, U$3.1 (A1); also elsewhere on the board
AD10: R49.2, U$2.2 (A2); also elsewhere on the board
AD11: R97.1, U$2.1 (A1); also elsewhere on the board
AD12: R50.2, U$1.2 (A2); also elsewhere on the board
AD13: R98.1, U$1.1 (A1); also elsewhere on the board
AD14: R51.2, U$13.2 (A2); also elsewhere on the board
AD15: R99.1, U$13.1 (A1); also elsewhere on the board
AD16: R52.2, U$14.2 (A2); also elsewhere on the board
AD17: R100.1, U$14.1 (A1); also elsewhere on the board
AD18: R53.2, U$15.2 (A2); also elsewhere on the board
AD19: R101.1, U$15.1 (A1); also elsewhere on the board
AOUT_1: JP17.1, JP19.1; also elsewhere on the board
AOUT_2: JP17.2, JP19.2; also elsewhere on the board
AOUT_3: JP17.3, JP19.3; also elsewhere on the board
AOUT_4: JP17.4, JP19.4; also elsewhere on the board
AOUT_5: JP17.5, JP19.5; also elsewhere on the board
AOUT_6: JP17.6, JP19.6; also elsewhere on the board
AOUT_7: JP17.7, JP19.7; also elsewhere on the board
AOUT_8: JP17.8, JP19.8; also elsewhere on the board
D0: R54.2, U$16.2 (A2); also elsewhere on the board
D1: R102.1, U$16.1 (A1); also elsewhere on the board
D2: R55.2, U$17.2 (A2); also elsewhere on the board
D3: R103.1, U$17.1 (A1); also elsewhere on the board
D4: R56.2, U$18.2 (A2); also elsewhere on the board
D5: R104.1, U$18.1 (A1); also elsewhere on the board
D6: R57.2, U$19.2 (A2); also elsewhere on the board
D7: R105.1, U$19.1 (A1); also elsewhere on the board
D8: R58.2, U$20.2 (A2); also elsewhere on the board
D9: R106.1, U$20.1 (A1); also elsewhere on the board
D10: R59.2, U$21.2 (A2); also elsewhere on the board
D11: R107.1, U$21.1 (A1); also elsewhere on the board
D12: R60.2, U$22.2 (A2); also elsewhere on the board
D13: R108.1, U$22.1 (A1); also elsewhere on the board
D14: R61.2, U$23.2 (A2); also elsewhere on the board
D15: R109.1, U$23.1 (A1); also elsewhere on the board
D16: R62.2, U$24.2 (A2); also elsewhere on the board
D19: R111.1, U$50.1 (A1); also elsewhere on the board
D20: R64.2, U$49.2 (A2); also elsewhere on the board
D21: R112.1, U$49.1 (A1); also elsewhere on the board
D22: R65.2, U$37.2 (A2); also elsewhere on the board
D23: R113.1, U$37.1 (A1); also elsewhere on the board
D24: R66.2, U$36.2 (A2); also elsewhere on the board
D25: R114.1, U$36.1 (A1); also elsewhere on the board
DUT_CAN_N: R87.2, U$25.2 (A2); also elsewhere on the board
DUT_CAN_P: R135.1, U$25.1 (A1); also elsewhere on the board
DUT_CS: R85.2, U$48.2 (A2); also elsewhere on the board
DUT_LIN: R129.1, U$44.1 (A1); also elsewhere on the board
DUT_MISO: R86.2, U$26.2 (A2); also elsewhere on the board
DUT_MOSI: R132.1, U$47.1 (A1); also elsewhere on the board
DUT_ONEWIRE: R134.1, U$26.1 (A1); also elsewhere on the board
DUT_RX: R83.2, U$46.2 (A2); also elsewhere on the board
DUT_SCL: R131.1, U$46.1 (A1); also elsewhere on the board
DUT_SCLK: R133.1, U$48.1 (A1); also elsewhere on the board
DUT_SDA: R84.2, U$47.2 (A2); also elsewhere on the board
DUT_SH+: R91.1, U$9.1 (A1); also elsewhere on the board
DUT_SH-: R39.2, U$9.2 (A2); also elsewhere on the board
DUT_TX: R130.1, U$45.1 (A1); also elsewhere on the board
GND: JP6.58, JP6.60, JP20.58, JP20.60, R68.2, R115.1, U$1.3 (C), U$2.3 (C), U$3.3 (C), U$4.3 (C), U$6.3 (C), U$7.3 (C), U$8.3 (C), U$9.3 (C), U$13.3 (C), U$14.3 (C), U$15.3 (C), U$16.3 (C), U$17.3 (C), U$18.3 (C), U$19.3 (C), U$20.3 (C), U$21.3 (C), U$22.3 (C), U$23.3 (C), U$24.3 (C), U$25.3 (C), U$26.3 (C), U$36.3 (C), U$37.3 (C), U$44.3 (C), U$45.3 (C), U$46.3 (C), U$47.3 (C), U$48.3 (C), U$49.3 (C), U$50.3 (C); also elsewhere on the board
LDO1: JP6.5, JP6.6, JP6.59, JP20.5, JP20.6, JP20.59; also elsewhere on the board
LDO2: JP6.3, JP6.4, JP20.3, JP20.4; also elsewhere on the board
LDO3: JP6.1, JP6.2, JP20.1, JP20.2; also elsewhere on the board
unnamed: R87.1, SV1.2, SV2.2
unnamed: R135.2, SV1.1, SV2.1
unnamed: JP6.7, JP20.7, R39.1
unnamed: JP6.9, JP20.9, R42.1
unnamed: JP6.11, JP20.11, R43.1
unnamed: JP6.13, JP20.13, R45.1
unnamed: JP6.15, JP20.15, R47.1
unnamed: JP6.17, JP20.17, R48.1
unnamed: JP6.19, JP20.19, R49.1
unnamed: JP6.21, JP20.21, R50.1
unnamed: JP6.23, JP20.23, R51.1
unnamed: JP6.25, JP20.25, R52.1
unnamed: JP6.27, JP20.27, R53.1
unnamed: JP6.29, JP20.29, R54.1
unnamed: JP6.31, JP20.31, R55.1
unnamed: JP6.33, JP20.33, R56.1
unnamed: JP6.35, JP20.35, R57.1
unnamed: JP6.37, JP20.37, R58.1
unnamed: JP6.39, JP20.39, R59.1
unnamed: JP6.41, JP20.41, R60.1
unnamed: JP6.43, JP20.43, R61.1
unnamed: JP6.45, JP20.45, R62.1
unnamed: JP6.47, JP20.47, R63.1
unnamed: JP6.49, JP20.49, R64.1
unnamed: JP6.51, JP20.51, R65.1
unnamed: JP6.53, JP20.53, R66.1
unnamed: JP6.55, JP20.55, R67.1
unnamed: JP6.57, JP20.57, R68.1
unnamed: SV1.14, SV2.14
unnamed: R82.1, SV1.12, SV2.12
unnamed: R83.1, SV1.10, SV2.10
unnamed: R84.1, SV1.8, SV2.8
unnamed: R85.1, SV1.6, SV2.6
unnamed: R86.1, SV1.4, SV2.4
unnamed: SV1.19, SV2.19
unnamed: R129.2, SV1.13, SV2.13
unnamed: R130.2, SV1.11, SV2.11
unnamed: R131.2, SV1.9, SV2.9
unnamed: R132.2, SV1.7, SV2.7
unnamed: R133.2, SV1.5, SV2.5
unnamed: R134.2, SV1.3, SV2.3
unnamed: JP6.8, JP20.8, R91.2
unnamed: JP6.10, JP20.10, R92.2
unnamed: JP6.12, JP20.12, R93.2
unnamed: JP6.14, JP20.14, R94.2
unnamed: JP6.16, JP20.16, R95.2
unnamed: JP6.18, JP20.18, R96.2
unnamed: JP6.20, JP20.20, R97.2
unnamed: JP6.22, JP20.22, R98.2
unnamed: JP6.24, JP20.24, R99.2
unnamed: JP6.26, JP20.26, R100.2
unnamed: JP6.28, JP20.28, R101.2
unnamed: JP6.30, JP20.30, R102.2
unnamed: JP6.32, JP20.32, R103.2
unnamed: JP6.34, JP20.34, R104.2
unnamed: JP6.36, JP20.36, R105.2
unnamed: JP6.38, JP20.38, R106.2
unnamed: JP6.40, JP20.40, R107.2
unnamed: JP6.42, JP20.42, R108.2
unnamed: JP6.44, JP20.44, R109.2
unnamed: JP6.46, JP20.46, R110.2
unnamed: JP6.48, JP20.48, R111.2
unnamed: JP6.50, JP20.50, R112.2
unnamed: JP6.52, JP20.52, R113.2
unnamed: JP6.54, JP20.54, R114.2
unnamed: JP6.56, JP20.56, R115.2
NRESET: SV1.20, SV2.20; also elsewhere on the board
SWDCLK/TCLK/SCK: SV1.16, SV2.16; also elsewhere on the board
SWDIO/TMS: SV1.18, SV2.18; also elsewhere on the board
SWO/TDO/MOSI: SV1.15, SV2.15; also elsewhere on the board
TDI/MISO: SV1.17, SV2.17; also elsewhere on the board
TSTR_SCL: R110.1, U$24.1 (A1); also elsewhere on the board
TSTR_SDA: R63.2, U$50.2 (A2); also elsewhere on the board
