bindebende/HILTester/HIL/HIL.brd

## EAGLE design HIL/HIL.brd (continued)

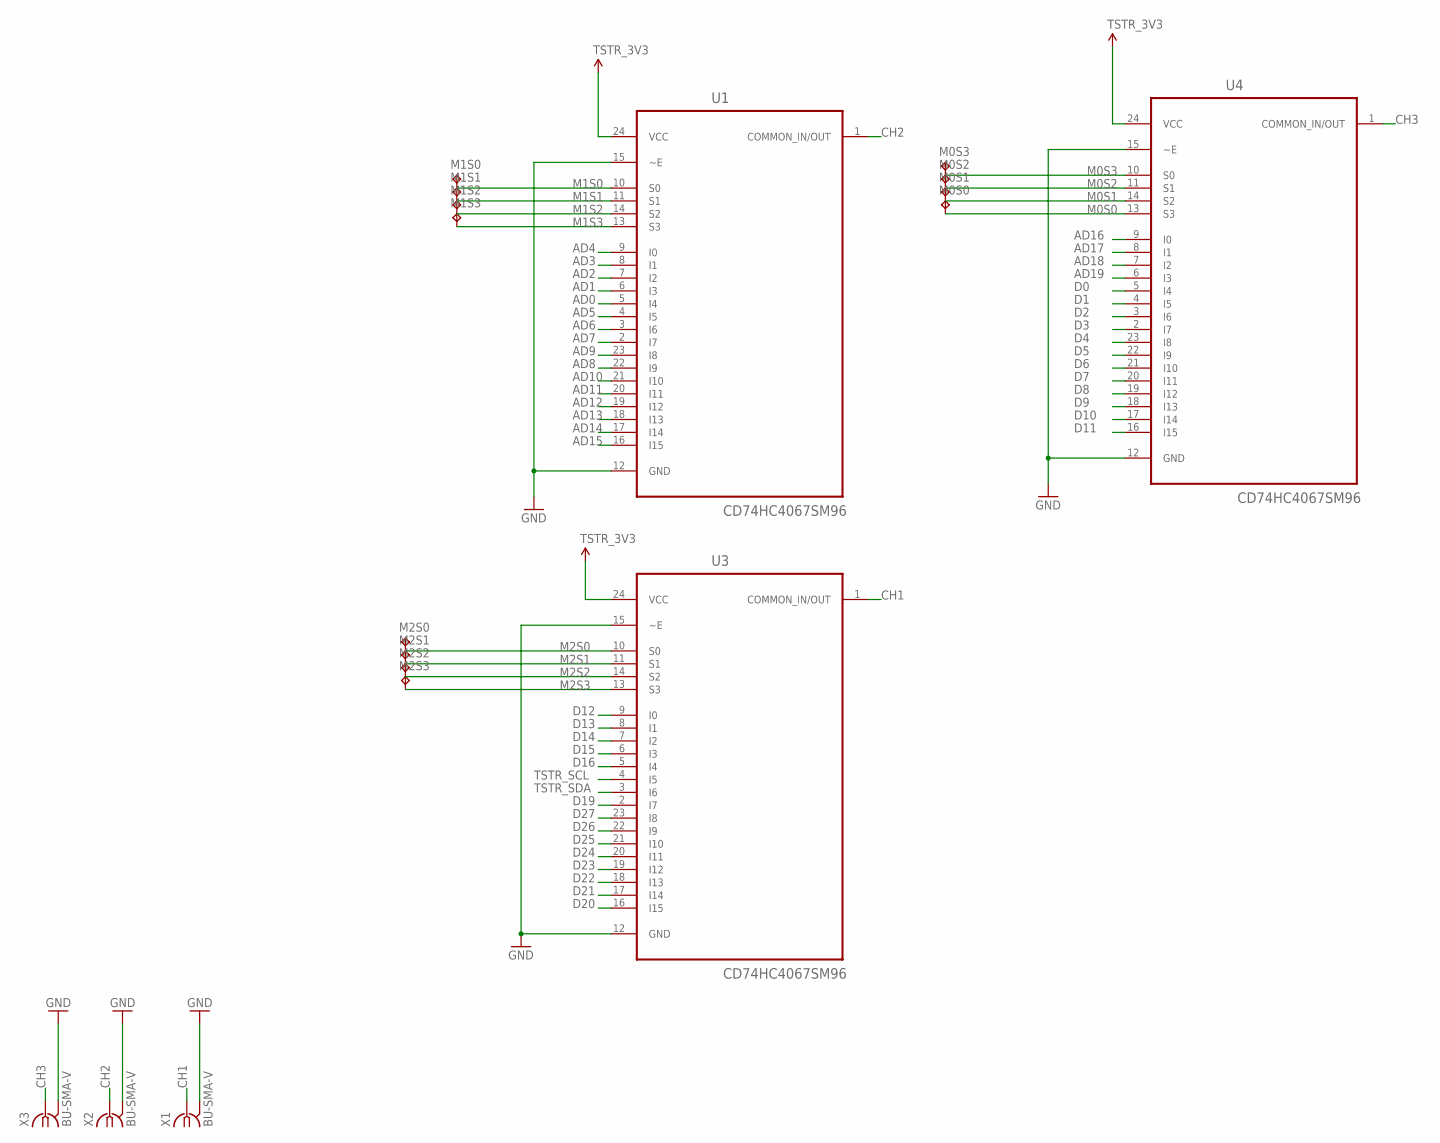
[picture p14: schematic HIL.sch, sheet 5, scope interface]

Parts:
M0S0, M0S1, M0S2, M0S3: TPB1,27; B1,27
M1S0, M1S1, M1S2, M1S3, M2S0, M2S1, M2S2, M2S3: M0S3; B1,27
U1, U3, U4: CD74HC4067SM96; SOP65P780X200-24N
X1, X2, X3: BU-SMA-V

Connections:
AD0: U1.5 (I4); also elsewhere on the board
AD1: U1.6 (I3); also elsewhere on the board
AD2: U1.7 (I2); also elsewhere on the board
AD3: U1.8 (I1); also elsewhere on the board
AD4: U1.9 (I0); also elsewhere on the board
AD5: U1.4 (I5); also elsewhere on the board
AD6: U1.3 (I6); also elsewhere on the board
AD7: U1.2 (I7); also elsewhere on the board
AD8: U1.22 (I9); also elsewhere on the board
AD9: U1.23 (I8); also elsewhere on the board
AD10: U1.21 (I10); also elsewhere on the board
AD11: U1.20 (I11); also elsewhere on the board
AD12: U1.19 (I12); also elsewhere on the board
AD13: U1.18 (I13); also elsewhere on the board
AD14: U1.17 (I14); also elsewhere on the board
AD15: U1.16 (I15); also elsewhere on the board
AD16: U4.9 (I0); also elsewhere on the board
AD17: U4.8 (I1); also elsewhere on the board
AD18: U4.7 (I2); also elsewhere on the board
AD19: U4.6 (I3); also elsewhere on the board
CH1: U3.1 (COMMON_IN/OUT), X1.1
CH2: U1.1 (COMMON_IN/OUT), X2.1
CH3: U4.1 (COMMON_IN/OUT), X3.1
D0: U4.5 (I4); also elsewhere on the board
D1: U4.4 (I5); also elsewhere on the board
D2: U4.3 (I6); also elsewhere on the board
D3: U4.2 (I7); also elsewhere on the board
D4: U4.23 (I8); also elsewhere on the board
D5: U4.22 (I9); also elsewhere on the board
D6: U4.21 (I10); also elsewhere on the board
D7: U4.20 (I11); also elsewhere on the board
D8: U4.19 (I12); also elsewhere on the board
D9: U4.18 (I13); also elsewhere on the board
D10: U4.17 (I14); also elsewhere on the board
D11: U4.16 (I15); also elsewhere on the board
D12: U3.9 (I0); also elsewhere on the board
D13: U3.8 (I1); also elsewhere on the board
D14: U3.7 (I2); also elsewhere on the board
D15: U3.6 (I3); also elsewhere on the board
D16: U3.5 (I4); also elsewhere on the board
D19: U3.2 (I7); also elsewhere on the board
D20: U3.16 (I15); also elsewhere on the board
D21: U3.17 (I14); also elsewhere on the board
D22: U3.18 (I13); also elsewhere on the board
D23: U3.19 (I12); also elsewhere on the board
D24: U3.20 (I11); also elsewhere on the board
D25: U3.21 (I10); also elsewhere on the board
D26: U3.22 (I9)
D27: U3.23 (I8)
GND: U1.12 (GND), U1.15 (~E), U3.12 (GND), U3.15 (~E), U4.12 (GND), U4.15 (~E), X1.2, X1.3 (2), X1.4 (2), X1.5 (2), X2.2, X2.3 (2), X2.4 (2), X2.5 (2), X3.2, X3.3 (2), X3.4 (2), X3.5 (2); also elsewhere on the board
M0S0: M0S0.TP, U4.13 (S3)
M0S1: M0S1.TP, U4.14 (S2)
M0S2: M0S2.TP, U4.11 (S1)
M0S3: M0S3.TP, U4.10 (S0)
M1S0: M1S0.TP, U1.10 (S0)
M1S1: M1S1.TP, U1.11 (S1)
M1S2: M1S2.TP, U1.14 (S2)
M1S3: M1S3.TP, U1.13 (S3)
M2S0: M2S0.TP, U3.10 (S0)
M2S1: M2S1.TP, U3.11 (S1)
M2S2: M2S2.TP, U3.14 (S2)
M2S3: M2S3.TP, U3.13 (S3)
TSTR_3V3: U1.24 (VCC), U3.24 (VCC), U4.24 (VCC); also elsewhere on the board
TSTR_SCL: U3.4 (I5); also elsewhere on the board
TSTR_SDA: U3.3 (I6); also elsewhere on the board

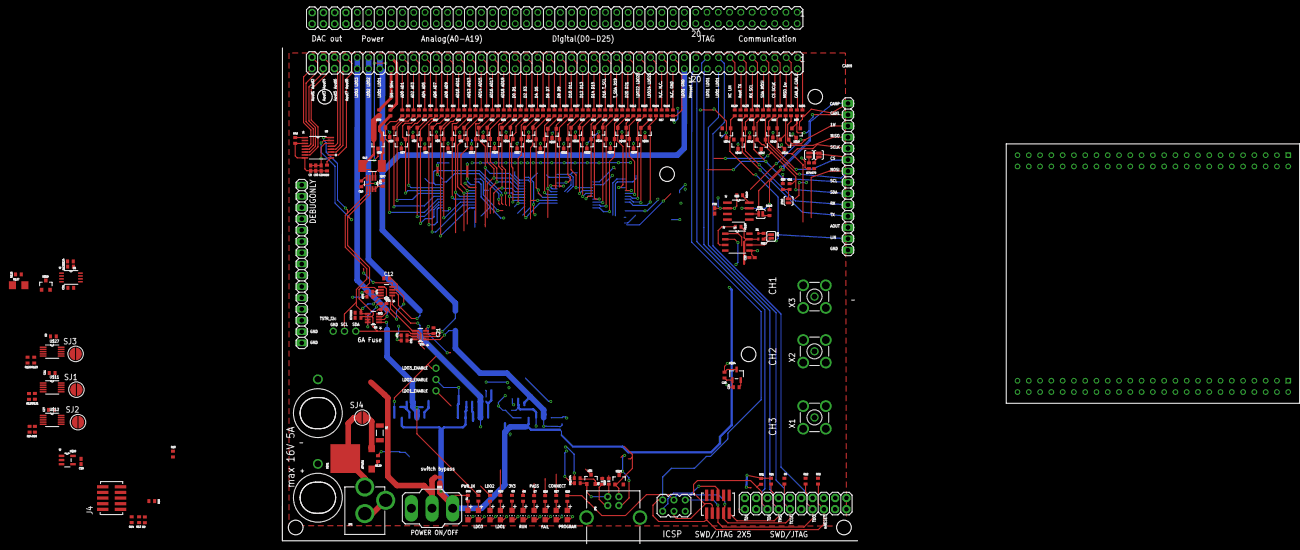
[picture p15: board HIL.brd from above]

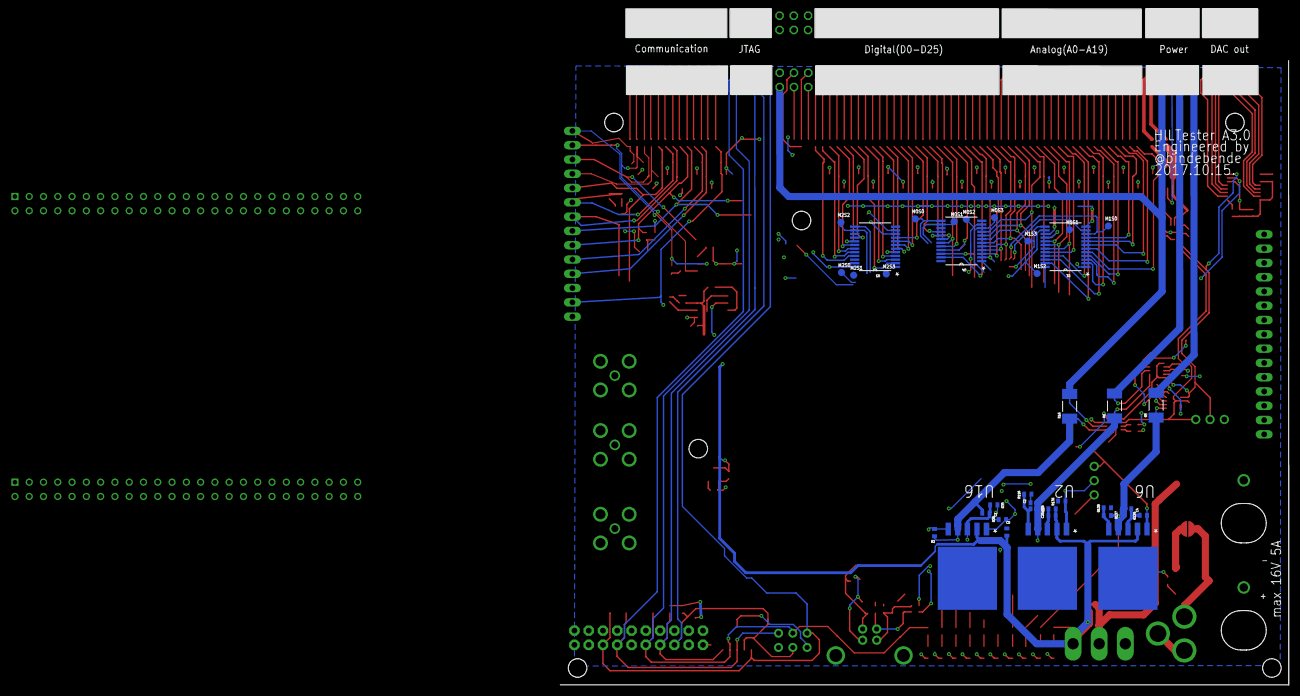
[picture p16: board HIL.brd from below]

Board: 2 copper layers, 129.5 x 111.0 mm, 269 parts (36 on the bottom side), 223 nets.

Other parts of the board:
STANDOFF1, STANDOFF5: STAND-OFF; STAND-OFF@1
