bindebende/HILTester/ExtensionBoards/PinBed.brd

## EAGLE design ExtensionBoards/PinBed.brd (2017-05-20)

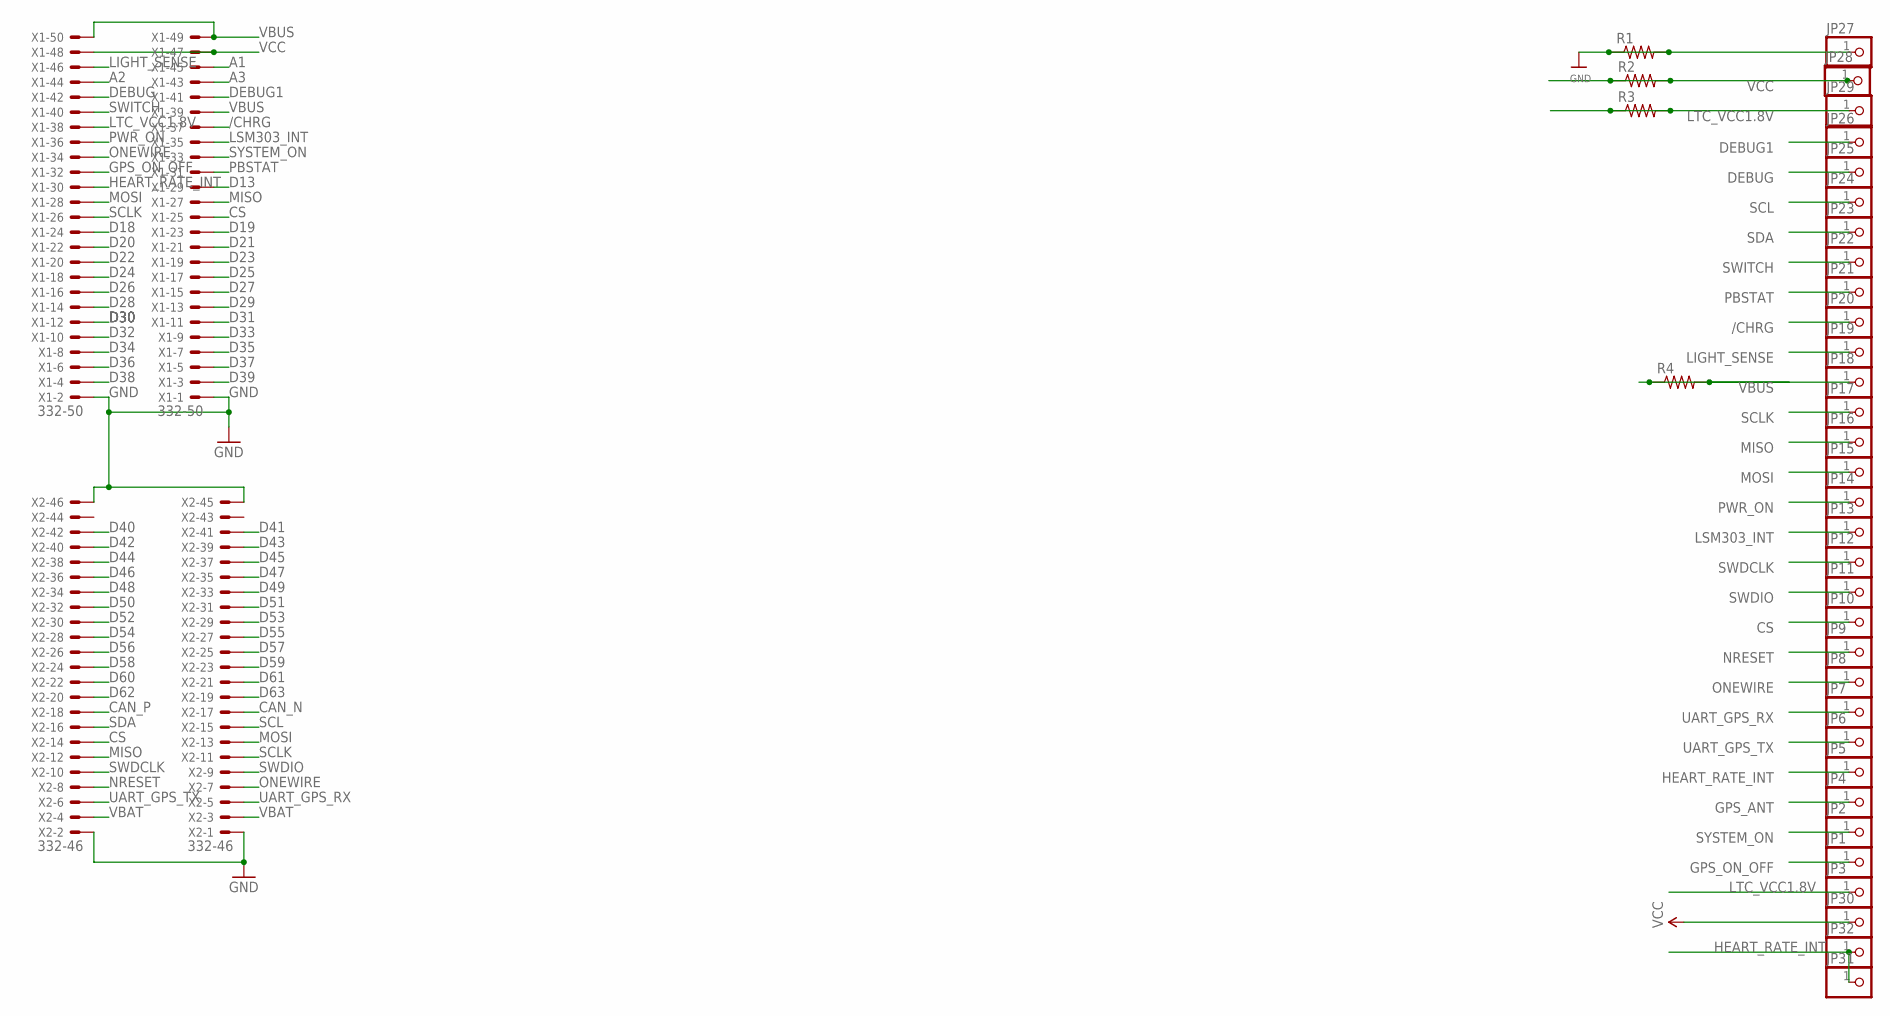
[picture p17: schematic PinBed.sch]

Parts:
JP1, JP2, JP3, JP4, JP5, JP6, JP7, JP8, JP9, JP10, JP11, JP12, JP13, JP14, JP15, JP16, JP17, JP18, JP19, JP20, JP21, JP22, JP23, JP24, JP25, JP26, JP27, JP28, JP29, JP30, JP31, JP32: PINHD-1X1CB; 1X01-CLEANBIG
R1, R2, R3, R4: RESISTOR0805-RES; 0805
X1: 332-50
X2: 332-46

Connections:
/CHRG: JP20.1, X1.37
A1: X1.45
A2: X1.44
A3: X1.43
CAN_N: X2.17
CAN_P: X2.18
CS: JP10.1, X1.25, X2.14
D13: X1.29
D18: X1.24
D19: X1.23
D20: X1.22
D21: X1.21
D22: X1.20
D23: X1.19
D24: X1.18
D25: X1.17
D26: X1.16
D27: X1.15
D28: X1.14
D29: X1.13
D30: X1.12
D31: X1.11
D32: X1.10
D33: X1.9
D34: X1.8
D35: X1.7
D36: X1.6
D37: X1.5
D38: X1.4
D39: X1.3
D40: X2.42
D41: X2.41
D42: X2.40
D43: X2.39
D44: X2.38
D45: X2.37
D46: X2.36
D47: X2.35
D48: X2.34
D49: X2.33
D50: X2.32
D51: X2.31
D52: X2.30
D53: X2.29
D54: X2.28
D55: X2.27
D56: X2.26
D57: X2.25
D58: X2.24
D59: X2.23
D60: X2.22
D61: X2.21
D62: X2.20
D63: X2.19
DEBUG: JP25.1, X1.42
DEBUG1: JP26.1, X1.41
GND: JP27.1, R1.1, R1.2, X1.1, X1.2, X2.1, X2.2, X2.45, X2.46
GPS_ANT: JP4.1
GPS_ON_OFF: JP1.1, X1.32
HEART_RATE_INT: JP5.1, JP31.1, JP32.1, X1.30
LIGHT_SENSE: JP19.1, X1.46
LSM303_INT: JP13.1, X1.35
LTC_VCC1.8V: JP3.1, JP29.1, R3.1, R3.2, X1.38
MISO: JP16.1, X1.27, X2.12
MOSI: JP15.1, X1.28, X2.13
NRESET: JP9.1, X2.8
ONEWIRE: JP8.1, X1.34, X2.7
PBSTAT: JP21.1, X1.31
PWR_ON: JP14.1, X1.36
SCL: JP24.1, X2.15
SCLK: JP17.1, X1.26, X2.11
SDA: JP23.1, X2.16
SWDCLK: JP12.1, X2.10
SWDIO: JP11.1, X2.9
SWITCH: JP22.1, X1.40
SYSTEM_ON: JP2.1, X1.33
UART_GPS_RX: JP7.1, X2.5
UART_GPS_TX: JP6.1, X2.6
VBAT: X2.3, X2.4
VBUS: JP18.1, R4.1, R4.2, X1.39, X1.49, X1.50
VCC: JP28.1, JP30.1, R2.1, R2.2, X1.47, X1.48

Board: 2 copper layers, 38 parts (0 on the bottom side), 28 nets, no tracks yet.
