bindebende/HILTester/(commit log)

2017-05-20 First initial commit of the tester moved from neogeo
    [PinBed.brd, PinBed.sch, PinBed_FOR_A3.skp, PinBed_FOR_A3.stp, RelayBoard.brd, RelayBoard.sch, RelayBoard_BOM.csv, Relay_A3.skp]
2017-06-04 remove: - ioexpanders add: - tm4c129 mcu - plus two multiplexer and two BNC connector - 139x115mm board size
    [RelayBoard.brd, RelayBoard.sch]
2017-06-05 additions
    - common connector for isp, jtag, swd
    - change LDOs to the one which have Enable pin
    - UART -> USB interface and isolator to the uart side
    - dedicated MCU supply
    [RelayBoard.brd, RelayBoard.sch]
2017-10-09 layout done
    Add: - binding posts with 19.05 mm spacing
    - top/bottom VCC/GND plane
    [RelayBoard.brd, RelayBoard.sch]
2017-10-09 fix - close cap to mcu
    [RelayBoard.brd]
2017-10-11 Fix issues
    [RelayBoard.brd]
2017-10-11 File system change
    names: relayboard -> HIL
    rearange files to folders
    [HIL.brd, HIL.sch, HIL_BOM.csv, RelayBoard.sch, Relay_A3.skp]
2017-10-11 Add switch bypass resistor
2017-10-11 Extend plane
    Extend TSTR_3V3’s plane
    [HIL.brd]
2017-10-13 smal fixes
    better 3v3 plane coverage
    add labels
    fix tracks which are not straight or 45 degree
    [HIL.brd, HIL.sch]
2017-10-13 Change: - MCU to a proper package Add: - labels - i2c header - UART header
    [HIL.brd, HIL.sch]
2017-10-14 change the position of the holes fix component libaries
    [HIL.brd, HIL.sch]
2017-10-14 Add RACK.brd to evaluate the dimensions of the rack
    [HIL.brd, RACK.brd]
2017-10-16 Generate pdfs, and gerbers Libraries “>NAME” parameter change
    [HIL.brd, HIL.sch, RACK.brd, Relay_A3.skp]
2017-10-16 Generate BOM
    [HIL_BOM_A2.csv]
2017-10-18 Rename folder PinBed to ExtensionBoards
    [PinBed.brd, PinBed.sch, PinBed_FOR_A3.skp, PinBed_FOR_A3.stp]
2017-10-19 Fix: - Vcc pin present in the schematic Add: - digital tersistor to the schematic - measurements of the holes/drills
    [HIL.brd, HIL.sch]
2017-10-23 Remove: 1 chanel DAC Add: 8 CH DAC Update: libraries
    [HIL.brd, HIL.sch]
2017-10-24 Add: - dac headers - labels to all the headers
    [HIL.brd, HIL.sch]
2017-10-25 Add DAC layout
    [HIL.brd, HIL.sch]
2018-02-04 start the A3.0
    [HIL.brd, HIL.sch]
